tuffinmuffin/battery-cart/CAD/Fan/2510FanOverhead.png

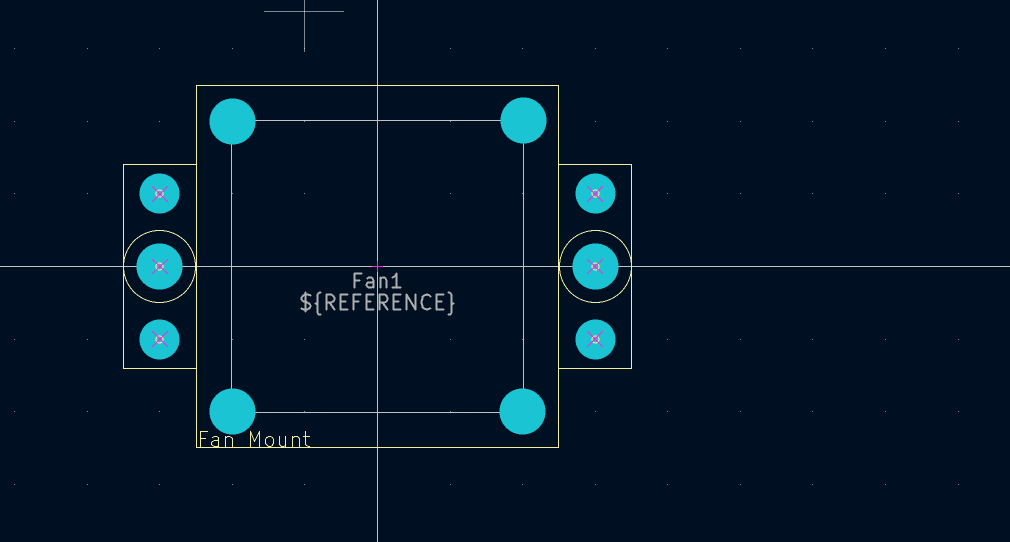
CAD/Fan/2510FanOverhead.png
