tuffinmuffin/battery-cart/Docs/frc_bom_v19.xlsx

Sheet: Bay PCB BOM
FRC Battery Monitor — Bay Control PCB BOM (Rev 0.1 · April 2026) Components soldered onto the bay board only.
Ref Des | Friendly Name | Qty | Description | Manufacturer | MPN | Package / Ordering note | Status | DigiKey / Order PN | MFR Datasheet | DK Datasheet | Price 1x | Price 10x | Stock | Notes / Design Requirements | KiCad Symbol | KiCad Footprint | Sch Page
Ordering policy: Packaging type (tube/cut tape/bulk) not relevant — priority is lowest per-unit cost at qty 1–10 for manual assembly. DigiKey cut tape / MouseReel / AliExpress singles all acceptable. Avoid full-reel minimums. Prices marked CHECK must be verified live — subject to tariffs.
1. MICROCONTROLLER
U1 | U1 | 1 | MCU — ARM Cortex-M0+ 64MHz USB FS I2C ADC 256KB flash | STMicroelectronics | STM32G0B1CCT6 | LQFP48 7×7mm 0.5mm pitch — singles or cut tape | SELECTED | STM32G0B1CCT6-ND (https://www.digikey.com/en/products/detail/stmicroelectronics/STM32G0B1CCT6/18086132) | MFR DS (https://www.st.com/resource/en/datasheet/stm32g0b1cc.pdf) | DK DS (https://www.digikey.com/en/products/detail/stmicroelectronics/STM32G0B1CCT6/18086132) | ~$2.80 | ~$2.50 | In Stock | 256KB flash · 144KB RAM · crystal-less USB FS · 64MHz · ~37 usable GPIO. LQFP48 7×7mm 0.5mm pitch — right-sized for this application. GPIO budget: 17 pins committed, ~20 spare. Same silicon as RCT6 (LQFP64) — identical firmware, peripherals, USB. Smaller footprint improves PCB placement. LQFP64 RCT6 rejected: 24 excess GPIO, larger footprint, ~$0.70 more. Dev board: NUCLEO-G0B1RE uses RCT6 — compatible for firmware dev, layout uses CCT6 pinout. | — | — | —
2. CURRENT / VOLTAGE MONITOR
U2 | U2 | 1 | Current/voltage/power monitor — I2C 16-bit bidirectional external shunt | Texas Instruments | INA226AQDGSRQ1 | VSSOP-10 0.5mm pitch — tube, singles | SELECTED | 296-43708-1-ND (https://www.digikey.com/en/products/detail/texas-instruments/INA226AQDGSRQ1/5404241) | MFR DS (https://www.ti.com/lit/ds/symlink/ina226.pdf) | DK DS (https://www.digikey.com/en/products/detail/texas-instruments/INA226AQDGSRQ1/5404241) | $2.58 | CHECK | 5.6M In Stock | 36V CM · ±81.92mV diff input · 16 I2C addr (0x40–0x4F) · 0.1% gain error · alert pin. Tube pkg (AIDGST) — easy singles. ⚑ VSSOP-10 0.5mm pitch: use flux + fine tip. Chosen over INA260: 57% cheaper, 5× better resolution, no obsolescence risk. | — | — | —
R1 | R_SHUNT | 1 | Current sense shunt — 10mΩ ±1% 2W metal strip 2512 | Vishay Dale | WSL2512R0100FEK18 | 2512 SMD — cut tape, singles | SELECTED | WSL-.01LFKR-ND (https://www.digikey.com/en/products/detail/vishay-dale/WSL2512R0100FEK18/9754181) | MFR DS (https://www.vishay.com/docs/20052/wsl.pdf) | DK DS (https://www.digikey.com/en/products/detail/vishay-dale/WSL2512R0100FEK18/9754181) | ~$0.50 | ~$0.40 | In Stock | 10mΩ: 5A→50mV ✓ 1.8A→18mV ✓ 250mW at 5A (well within 2W). TCR ±75ppm/°C. 2512 large pads — hand-solderable. ⚑ LAYOUT: Kelvin routing — sense traces to INA226 IN+/IN− at inner pad edges only. | MCU_ST_STM32G0:STM32G0B1CCTx | Package_QFP:LQFP-48_7x7mm_P0.5mm | 3-MCU
⚑ INA226 required passives and connections: (1) C_INA_VS: 100nF ceramic directly at VS pin — mandatory per TI datasheet typical application. (2) R_ALERT: 10kΩ pull-up from ALERT pin to VS (3.3V) — enables interrupt-driven fault detection. (3) A0/A1: both tie directly to GND via short trace → I2C address 0x40. No resistors needed. (4) VBUS pin: connect to IN− node (battery terminal, load side of shunt) to read terminal voltage. ALERT active-low open-drain: pulls low on over-current/over-voltage/under-voltage/conversion-ready. STM32 GPIO configured as input with internal pull-up (40kΩ typ), falling-edge interrupt. No external R_ALERT needed — STM32 internal pull-up adequate (82µA sink at 40kΩ, well within INA226 10mA IOUT max). VBUS: 100nF DNP footprint (C_VBUS) for optional ripple suppression when no battery present.
C17 | C_INA_VS | 1 | 100nF X7R 10V 0603 — INA226 VS power supply bypass | Generic | 100nF X7R 10V 0603 | 0603 — cut tape | SELECTED | — | — | — | ~$0.01 | ~$0.01 | In Stock | Mandatory per INA226 datasheet typical application circuit. Place immediately adjacent to VS pin (pin 6). Low-ESR X7R ceramic. This is a precision analog IC — bypass cap placement is critical for measurement accuracy. LAYOUT: within 2mm of VS pin, GND via immediately adjacent. | — | — | —
C19 | C19 | 1 | 100nF X7R 25V 0603 — INA226 VBUS ripple filter — DNP default | Generic | 100nF X7R 25V 0603 | 0603 — cut tape | DNP | — | — | — | ~$0.01 | ~$0.01 | In Stock | DNP in normal operation — battery bulk capacitance suppresses charger ripple adequately. Populate if VBUS ripple causes measurement noise during bring-up (charger connected, no battery). Charger is designed to run unloaded and does not spike — 25V rating is precautionary headroom only. Relay NC fail-safe connects CHG+ to battery path when MCU off — board transparent to charger. 100nF same value as C_BYPASS — no new stock needed. | — | — | —
3. POWER SUPPLY
U3 | U3 | 1 | Buck converter — 12V → 3.3V 2A, primary rail (12V present) | Diodes Inc | AP63203WU-7 | SOT-23-6 (TSOT-26) — singles or cut tape | SELECTED | AP63203WU-7DICT-ND (https://www.digikey.com/en/products/detail/diodes-incorporated/AP63203WU-7/9858430) | MFR DS (https://www.diodes.com/assets/Datasheets/AP63200-AP63201-AP63203-AP63205.pdf) | DK DS (https://www.digikey.com/en/products/detail/diodes-incorporated/AP63203WU-7/9858430) | ~$0.60 | ~$0.50 | In Stock | 3.8–32V input · fixed 3.3V output · 2A · integrated MOSFETs · FSS EMI reduction · PG open-drain pin. Requires 4 external passives: L1 (3.9µH), C_IN (10µF), C_OUT (22µF), C_BST (100nF). PG open-drain pin connects directly to MIC5219 EN via R_PG pull-up — no transistor needed. | — | — | —
U4 | U4 | 1 | LDO regulator — VBUS 5V → 3.3V, USB-only fallback (12V absent) | Microchip | MIC5219-3.3YM5-TR | SOT-23-5 — singles or cut tape | SELECTED | MIC5219-3.3YM5-TRCT-ND (https://www.digikey.com/en/products/detail/microchip-technology/MIC5219-3.3YM5-TR/771902) | MFR DS (https://ww1.microchip.com/downloads/en/DeviceDoc/MIC5219.pdf) | DK DS (https://www.digikey.com/en/products/detail/microchip-technology/MIC5219-3.3YM5-TR/771902) | ~$0.50 | ~$0.40 | In Stock | 500mA · low noise · EN pin (active-high) · NO active output discharge — output decays passively through load. EN driven directly by AP63203 PG pin via R_PG pull-up to VBUS. No transistor needed. PG asserted (low, 12V healthy) → EN low → LDO off. PG released (12V absent) → EN pulled high via R_PG → LDO on from VBUS. MIC5219 chosen over AP2112K specifically because AP2112K has active auto-discharge which would fight the buck rail during startup. MIC5219 shuts down passively — safe to share rail. USB always connected to Pi for CDC data — VBUS always present. Board draw at 3.3V ≈ 170–200mA — within 500mA rating. | Regulator_Switching:AP63203WU-7 | Package_TO_SOT_SMD:SOT-23-6 | 2-PwrSupply
⚑ Power OR-ing/mux IC (originally designated U5) ELIMINATED — no discrete power mux IC needed for 3.3V rail. A dedicated power multiplexer IC was initially considered to OR the buck and LDO outputs onto the 3.3V rail, but was eliminated when it was found that AP63203 PG pin drives MIC5219 EN directly via R_PG pull-up — the PG/EN logic relationship maps correctly without any additional IC or transistor inversion. Q_PG transistor also eliminated for same reason. R_EN eliminated — R_PG pull-up to VBUS serves both roles. NOTE: U5 designator subsequently re-assigned to AP63205 5V_LED buck converter (Section 3b).
R9 | R_PG | 1 | 100kΩ ±5% 0603 — pull-up: AP63203 PG to VBUS, also drives MIC5219 EN | Generic | 100kΩ ±5% 0603 | 0603 — cut tape, singles | SELECTED | — | — | — | ~$0.01 | ~$0.01 | In Stock | PG is open-drain active-low. Pull-up to VBUS ensures EN is high (LDO on) when 12V absent. When PG asserts low, it pulls EN low through this resistor — no transistor inversion needed because MIC5219 EN is active-high and PG active-low maps correctly: PG low = EN low = LDO off. | Device:R | Resistor_SMD:R_0603_1608Metric | 2-PwrSupply
L1 | L1 | 1 | Inductor — 3.9µH shielded power inductor for AP63203 buck converter | Bourns | SRR4028-3R9Y | 4.8×4.8×2.8mm SMD — singles or cut tape | SELECTED | SRR4028-3R9YCTR-ND (https://www.digikey.com/en/products/detail/bourns-inc/SRR4028-3R9Y/2127507) | MFR DS (https://www.bourns.com/docs/Product-Datasheets/SRR4028.pdf) | DK DS (https://www.digikey.com/en/products/detail/bourns-inc/SRR4028-3R9Y/2127507) | ~$0.35 | ~$0.28 | In Stock | 3.9µH per AP63203 Table 2/3 recommendation (not 4.7µH — that is the AP63205 5V variant). Shielded drum core · Irms 1.72A · DCR 60mΩ max · 4.8×4.8×2.8mm. At our ~200mA actual load, peak ripple current ≈0.48A — well within 1.72A rating. DCR 60mΩ < 100mΩ datasheet limit. | Device:L | Inductor_SMD:L_Bourns_SRR4028 | 2-PwrSupply
C4 | C_12V_IN | 1 | 10µF ±20% X5R 25V 0805 — 12V rail bulk cap at board entry | Generic | 10µF X5R 25V 0805 | 0805 — cut tape, singles | SELECTED | — | — | — | ~$0.05 | ~$0.04 | In Stock | Bulk capacitor on 12V rail at entry point — after F1 fuse, before branching to U3/U5/relay. Absorbs connector insertion inductance and any ESD transients from battery connection. Same value as C_IN/C_5V_IN — one value to stock. 25V rating = 2× 12V input. LAYOUT: place close to input connector, on the load side of F1. | — | — | —
C5 | C_U4_IN | 1 | 1µF ±20% X5R 10V 0603 — MIC5219 LDO VIN bypass | Generic | 1µF X5R 10V 0603 | 0603 — cut tape, singles | SELECTED | — | — | — | ~$0.02 | ~$0.01 | In Stock | MIC5219 datasheet: 1µF input cap recommended. VIN = VBUS (5V). LAYOUT: place close to U4 VIN pin. | — | — | —
C6 | C_U4_OUT | 1 | 1µF ±20% X5R 10V 0603 — MIC5219 LDO VOUT cap (stability required) | Generic | 1µF X5R 10V 0603 | 0603 — cut tape, singles | SELECTED | — | — | — | ~$0.02 | ~$0.01 | In Stock | MIC5219 datasheet: minimum 1µF output cap required for stability — do not omit. Without output cap LDO may oscillate. Low-ESR ceramic only. LAYOUT: place immediately adjacent to U4 VOUT pin, before connecting to 3.3V rail. 3.3V rail bulk (C_BULK_3V3, C_VDD_BULK) are additional — this is the LDO-local stability cap. | — | — | —
C1 | C_IN | 1 | 10µF ±20% X5R 25V 0805 — AP63203 input cap, ripple suppression | Generic | 10µF X5R 25V 0805 | 0805 — cut tape, singles | SELECTED | — | — | — | ~$0.05 | ~$0.04 | In Stock | Per AP63203 datasheet Table 2. Low ESR ceramic. 25V rating = 2×Vin headroom on 12V supply. Place close to VIN and GND pins. | — | — | —
C2 | C_OUT | 1 | 22µF ±20% X5R 6.3V 0805 — AP63203 output cap, ripple and transient | Generic | 22µF X5R 6.3V 0805 | 0805 — cut tape, singles | SELECTED | — | — | — | ~$0.08 | ~$0.06 | In Stock | Per AP63203 datasheet Table 2. Low ESR ceramic. 6.3V rating ≥ 2×Vout (3.3V). Single 22µF sufficient at our load — add second in parallel if ripple measurement requires. | — | — | —
C3 | C_BST | 1 | 100nF X7R 10V 0402 — AP63203 bootstrap cap, BST to SW pin | Generic | 100nF X7R 10V 0402 | 0402 — cut tape, singles | SELECTED | — | — | — | ~$0.01 | ~$0.01 | In Stock | Required by AP63203 — must be placed between BST and SW pins. If BST cap voltage drops below 2.3V, internal UVP circuit refreshes it. 100nF ceramic. | — | — | —
3b. 5V LED POWER RAIL — DEDICATED SUPPLY FOR LED CHAIN
⚑ Dedicated 5V rail powering the WS2812B LED chain and level shifter. Sources from 12V via AP63205 buck, OR from VBUS (USB 5V) via Schottky diode — whichever is present. Architecture: 12V → U5(AP63205) → D_12V(Schottky) ─┬─ 5V_LED rail → LEDs + level shifter. VBUS → D_USB(Schottky) ─┘ This ensures LEDs operate (showing bay status) whenever 12V OR USB is present — including when Pi is off. WS2812B spec: VDD 3.5–5.3V, nominal 5V. Running at proper 5V eliminates out-of-spec concerns. Worst case draw: 6 LEDs × 54mA (full white) = 324mA. Typical: ~65mA at 20% brightness. U5 rated 2A — 6× worst-case headroom. Same part family as U3 (AP63203): identical footprint, same passives.
U5 | U5 | 1 | Buck converter — 12V → 5V 2A, LED chain power rail | Diodes Inc | AP63205WU-7 | SOT-23-6 (TSOT-26) — singles or cut tape | SELECTED | AP63205WU-7DICT-ND (https://www.digikey.com/en/products/detail/diodes-incorporated/AP63205WU-7/9858424) | MFR DS (https://www.diodes.com/assets/Datasheets/AP63200-AP63201-AP63203-AP63205.pdf) | DK DS (https://www.digikey.com/en/products/detail/diodes-incorporated/AP63205WU-7/9858424) | ~$0.70 | ~$0.60 | In Stock | 3.8–32V input · fixed 5V output · 2A · same die/package as U3(AP63205) · FSS EMI reduction. Identical footprint to U3 — share PCB footprint library entry. Efficiency ~85% at 12V→5V, 100mA typical load vs LDO worst-case 7V×324mA=2.3W dissipation. Passives same family as U3: L2(4.7µH), C_5V_IN(10µF), C_5V_OUT(22µF), C_BST2(100nF). Surge rated to 40V for 400ms — handles 12V battery transients. | — | — | —
L2 | L2 | 1 | Inductor — 4.7µH shielded power inductor for AP63205 5V buck | Bourns | SRR4028-4R7Y | 4.8×4.8×2.8mm SMD — singles | SELECTED | SRR4028-4R7YCTR-ND (https://www.digikey.com/en/products/detail/bourns-inc/SRR4028-4R7Y/2127508) | MFR DS (https://www.bourns.com/docs/Product-Datasheets/SRR4028.pdf) | DK DS (https://www.digikey.com/en/products/detail/bourns-inc/SRR4028-4R7Y/2127508) | ~$0.35 | ~$0.28 | In Stock | 4.7µH per AP63205 Table 3 recommendation for 5V output. Same SRR4028 series as L1 — identical footprint, different value. Irms 1.52A · DCR 75mΩ max. Well within rating at 324mA worst case. | Regulator_Switching:AP63205WU-7 | Package_TO_SOT_SMD:SOT-23-6 | 2-PwrSupply
D2 | D_12V | 1 | Schottky diode — 12V→5V reg output to 5V_LED rail (backfeed isolation) | MCC | MBR0530-TP | SOD-123 — singles | SELECTED | MBR0530TPMSCT-ND (https://www.digikey.com/en/products/detail/mcc-micro-commercial-components/MBR0530-TP/717251) | — | — | ~$0.14 | ~$0.11 | In Stock | 30V 500mA Schottky. Isolates 12V buck output from VBUS path. Vf ~0.35V @ 500mA — 5V_LED rail will be ~4.65V at full load. Acceptable for WS2812B (min 3.5V). | — | — | —
D3 | D_USB | 1 | Schottky diode — VBUS to 5V_LED rail (backfeed isolation from USB) | MCC | MBR0530-TP | SOD-123 — singles | SELECTED | MBR0530TPMSCT-ND (https://www.digikey.com/en/products/detail/mcc-micro-commercial-components/MBR0530-TP/717251) | — | — | ~$0.14 | ~$0.11 | In Stock | Same part as D_12V. Prevents 5V_LED rail backfeeding into VBUS when USB is absent. When both sources present: higher voltage wins (buck output will dominate slightly). | — | — | —
C7 | C_5V_IN | 1 | 10µF ±20% X5R 25V 0805 — AP63205 input cap | Generic | 10µF X5R 25V 0805 | 0805 — cut tape | SELECTED | — | — | — | ~$0.05 | ~$0.04 | In Stock | Same value as C_IN. Place close to U5 VIN pin. | — | — | —
C8 | C_5V_OUT | 1 | 22µF ±20% X5R 10V 0805 — AP63205 output cap | Generic | 22µF X5R 10V 0805 | 0805 — cut tape | SELECTED | — | — | — | ~$0.08 | ~$0.06 | In Stock | 10V rating ≥ 2×Vout(5V). Same as C_OUT. Place close to U5 output. | — | — | —
C9 | C_BST2 | 1 | 100nF X7R 10V 0402 — AP63205 bootstrap cap | Generic | 100nF X7R 10V 0402 | 0402 — cut tape | SELECTED | — | — | — | ~$0.01 | ~$0.01 | In Stock | Same as C_BST. Required between U5 BST and SW pins. Place immediately adjacent. | — | — | —
4. SWITCHING — RELAY & DRIVERS
K1 | K1 | 1 | SPDT relay — CHG+ switching, NC=charger (fail-safe), NO=bleed load path | Omron | G5LE-1 DC3 | PCB mount TH 5-pin — singles | SELECTED | Z3329-ND (https://www.digikey.com/en/products/detail/omron-electronics-inc-emc-div/G5LE-1-DC3/1815676) | MFR DS (https://omronfs.omron.com/en_US/ecb/products/pdf/en-g5le.pdf) | DK DS (https://www.digikey.com/en/products/detail/omron-electronics-inc-emc-div/G5LE-1-DC3/1815676) | $1.77 | CHECK | In Stock | SPDT 1 Form C · 3V rated coil · 10A AC / 8A DC contacts · 30VDC max · 22.5×16.5×19mm · 400mW coil. Must-operate = 75% of 3V = 2.25V — 3.3V rail via Q2 NPN is well above threshold. Coil draws 133mA — Q2 handles this, not GPIO direct. NC = CHG+ connected at rest (fail-safe). NO = bleed resistor top (test state). ⚑ No 5V rail on board — 3.3V rail only. Ref schematic: battery_test_protection_charging_circuit.svg | — | — | —
Q5 | Q4 (Fan FET) | 1 | NPN transistor — K1 relay coil driver (3.3V GPIO → 3V coil) | Generic | MMBT2222A or BC817-25LT1G | SOT-23 — cut tape, singles | SELECTED | — | — | — | ~$0.05 | ~$0.04 | In Stock | STM32 GPIO → R_GATE_K1 1kΩ → Q2 base. Collector drives 3V coil from 3.3V rail. Coil current 133mA — within transistor spec, well above 25mA GPIO limit. D1 flyback across coil. Candidates: MMBT2222A (SOT-23, ~$0.05 DK). | Device:Relay_SPDT | Relay_THT:Relay_SPDT_Omron-G5LE-1 | 1-BattPwr
D1 | D1 | 1 | Flyback diode — K1 relay coil transient suppression | Diodes Inc | 1N4148W-7-F | SOD-123 — cut tape, singles | SELECTED | 1N4148W-FDICT-ND (https://www.digikey.com/en/products/detail/diodes-incorporated/1N4148W-7-F/717311) | MFR DS (https://www.diodes.com/assets/Datasheets/ds30086.pdf) | DK DS (https://www.digikey.com/en/products/detail/diodes-incorporated/1N4148W-7-F/717311) | ~$0.03 | ~$0.02 | In Stock | Across K1 relay coil — cathode to 3.3V rail, anode to Q2 collector. Clamps coil back-EMF on relay release. SOD-123 hand-solderable. | — | — | —
5. FUSES — 12V INPUT PROTECTION (MINI BLADE / ATM)
⚑ All three 12V inputs fused with automotive mini blade (ATM/297 series). Holders PCB-mount through-hole — MPD BK-6013 (vertical entry mini blade). Fuses user-replaceable, color-coded, available at any auto parts store. Same ATM format as REV PDH low-current channels — teams will have spares in kit. Sizing provisional: F1+F2 = 7.5A, F3 = 2A. All easily swappable. Rated 32V DC.
F1 | F1 | 1 | Mini blade fuse 7.5A — BAT+ input protection (provisional) | Littelfuse | 02970007.5WXNV | Mini blade ATM — singles | SELECTED | WK-02970007.5WXNV-ND (https://www.digikey.com/en/products/detail/littelfuse-inc/02970007-5wxnv/762533) | MFR DS (https://www.littelfuse.com/~/media/automotive/datasheets/fuses/passenger-car/blade/littelfuse_atm.pdf) | DK DS (https://www.digikey.com/en/products/detail/littelfuse-inc/02970007-5wxnv/762533) | ~$0.25 | ~$0.20 | In Stock | 7.5A 32V mini blade (ATM). BAT+ path. Provisional — sizing TBD after load testing. Same format as REV PDH low-current fuses. Brown. Easily replaceable. | — | — | —
F2 | F2 | 1 | Mini blade fuse 7.5A — CHG+ input protection | Littelfuse | 02970007.5WXNV | Mini blade ATM — singles | SELECTED | WK-02970007.5WXNV-ND (https://www.digikey.com/en/products/detail/littelfuse-inc/02970007-5wxnv/762533) | MFR DS (https://www.littelfuse.com/~/media/automotive/datasheets/fuses/passenger-car/blade/littelfuse_atm.pdf) | DK DS (https://www.digikey.com/en/products/detail/littelfuse-inc/02970007-5wxnv/762533) | ~$0.25 | ~$0.20 | In Stock | 7.5A 32V mini blade (ATM). CHG+ path. Provisional — same value as F1 for simplicity. Same format as REV PDH low-current fuses. Brown. Easily replaceable. | Device:D_Schottky | Diode_SMD:D_SOD-123 | 1-BattPwr
F3 | F3 | 1 | Mini blade fuse 2A — 12V rail input to buck converter | Littelfuse | 0297002.WXNV | Mini blade ATM — singles | SELECTED | WK-0297002.WXNV-ND (https://www.digikey.com/en/products/detail/littelfuse-inc/0297002-wxnv/762528) | MFR DS (https://www.littelfuse.com/~/media/automotive/datasheets/fuses/passenger-car/blade/littelfuse_atm.pdf) | DK DS (https://www.digikey.com/en/products/detail/littelfuse-inc/0297002-wxnv/762528) | ~$0.25 | ~$0.20 | In Stock | 2A 32V mini blade (ATM). 12V rail to AP63203 buck. Provisional. Buck draws ~200mA at 12V — 2A gives 10× normal current margin. Grey. | — | — | —
FH1 FH2 FH3 | FH1 FH2 FH3 | 3 | Fuse holder — mini blade ATM vertical PCB through-hole (one per fuse) | MPD | BK-6013 | PCB TH vertical — singles | SELECTED | BK-6013-ND (https://www.digikey.com/product-detail/en/BK-6013/BK-6013-ND/2330532) | MFR DS (https://www.memoryprotectiondevices.com/documents/catalogs/MPD-Fuse-Holders.pdf) | DK DS (https://www.digikey.com/product-detail/en/BK-6013/BK-6013-ND/2330532) | ~$0.65 | ~$0.50 | In Stock | MPD BK-6013 — compact vertical holder with body for .110"×.032" mini blade (ATM). Glass-filled nylon body · nickel-plated brass contacts · PC pins · RoHS. Compatible with Littelfuse 297/ATM series. ~$0.65 DK single unit vs ~$1.20 for Keystone 3568. Keystone 3544-2 equivalent. One footprint for all three positions. | — | — | —
6. PROTECTION — POLARITY GUARD & LOAD SWITCH
Q1 | Q1 (Polarity Guard) | 1 | P-channel MOSFET — BAT+ reverse polarity guard (series, normally on) | Alpha & Omega | AO3401A | SOT-23-3 — cut tape, singles | SELECTED | AO3401A-ND (https://www.digikey.com/en/products/detail/alpha-omega-semiconductor-inc/AO3401A/1855773) | MFR DS (https://www.aosmd.com/res/datasheets/AO3401A.pdf) | DK DS (https://www.digikey.com/en/products/detail/alpha-omega-semiconductor-inc/AO3401A/1855773) | ~$0.46 | ~$0.37 | In Stock | Vds = −30V · Id = −4.0A steady-state (−18A pulsed) · Vgs(th) max −1V · RDS(on) < 50mΩ @ −10V. Adequate for reverse polarity guard: in normal op Q1 conducts ≤6.8A for short bleed-test duty cycles. F1 (7.5A) blows before Q1 thermals in true reverse/fault. DMG2305UX rejected: Vds = −20V too tight vs 14.4V FRC battery max. | — | — | —
R2 | R_G1 | 1 | 10kΩ ±5% 0603 — Q1 P-FET gate pull-down to GND | Generic | 10kΩ 0603 | 0603 preferred | SELECTED | — | — | — | ~$0.01 | ~$0.01 | In Stock | Q1 gate tied to GND via R_G1. Source = BAT+, so Vgs = 0 − BAT+ = negative → FET conducts normally. R_G1 defines gate firmly at GND — prevents floating gate during power-up and provides ESD discharge path. No switching required — Q1 is always-on series guard. No gate drive or turn-on resistor needed. 10kΩ same value as R_BOOT0 — one value to stock. | Device:Q_PMOS_GSD | Package_TO_SOT_SMD:SOT-23 | 1-BattPwr
5b. Q3 BLEED MOSFET — DUAL FOOTPRINT (TO-220 TH primary · D2PAK SMD alt)
⚑ DUAL FOOTPRINT: PCB carries both TO-220 through-hole pads and D2PAK (TO-263) SMD pads for Q3. Same electrical position — populate ONE only. TO-220 (IRFZ44NPBF) is primary; D2PAK (IRFZ44NSPBF) is SMD alternative, same die. Both require Q3_DRV NPN driver circuit. Silkscreen both outlines. Shared drain/source nodes. Courtyard = larger of the two.
Q5 | Q4 (Fan FET) | 1 | N-channel MOSFET — bleed load enable, low-side switch — TO-220 PRIMARY | Infineon | IRFZ44NPBF | TO-220AB through-hole | SELECTED | IRFZ44NPBF-ND (https://www.digikey.com/en/products/detail/infineon-technologies/IRFZ44NPBF/811772) | MFR DS (https://www.infineon.com/dgdl/Infineon-IRFZ44N-DataSheet-v01_01-EN.pdf) | DK DS (https://www.digikey.com/en/products/detail/infineon-technologies/IRFZ44NPBF/811772) | ~$1.39 | ~$1.11 | In Stock | Vds = 55V · Id = 49A · RDS(on) max 17.5mΩ @ Vgs=10V (fully guaranteed at spec drive voltage) · Standard threshold — driven at 10–12V via Q3_DRV NPN stage (see below). No heatsink needed: at 1.82A nominal P = 0.058W, TJ rise < 4°C in free air. DUAL FOOTPRINT: also fits IRFZ44NSPBF D2PAK on same pads. | — | — | —
Q5 | Q4 (Fan FET) | 1 | N-channel MOSFET — bleed load enable, low-side switch — D2PAK SMD ALTERNATIVE | Infineon | IRFZ44NSPBF | D2PAK (TO-263) SMD — same die as IRFZ44NPBF | DUAL | IRFZ44NSPBF-ND (https://www.digikey.com/en/products/detail/infineon-technologies/IRFZ44NSPBF/811988) | MFR DS (https://www.infineon.com/dgdl/Infineon-IRFZ44N-DataSheet-v01_01-EN.pdf) | DK DS (https://www.digikey.com/en/products/detail/infineon-technologies/IRFZ44NSPBF/811988) | ~$1.55 | ~$1.24 | In Stock | Identical silicon to IRFZ44NPBF. D2PAK tab-down SMD, copper pour on drain tab. Populate instead of TO-220 if SMD-only assembly preferred. Same driver circuit required. | Device:Q_NMOS_GDS | Package_TO_SOT_THT:TO-220-3_Vertical | 1-BattPwr
5c. Q3_DRV — NPN DRIVER FOR Q3 GATE
⚑ Q3 driven via NPN stage: STM32 GPIO (3.3V) → R_B3 → Q3_DRV base → collector pulls Q3 gate to GND (off). 12V rail via R_G3 (100Ω) charges Q3 gate to ~12V when Q3_DRV off (on). Logic inverted: GPIO HIGH = Q3 OFF, GPIO LOW = Q3 ON. Handle with invert flag in firmware. Same topology as Q2 relay driver. MMBT2222A already in BOM — same part, new instance.
Q5 | Q4 (Fan FET) | 1 | NPN transistor — Q3 gate driver (inverts STM32 GPIO to 12V gate drive) | Onsemi | MMBT2222ALT1G | SOT-23 SMD — same part as Q2 | SELECTED | MMBT2222ALT1GOSCT-ND (https://www.digikey.com/en/products/detail/onsemi/MMBT2222ALT1G/919595) | MFR DS (https://www.onsemi.com/pdf/datasheet/mmbt2222a-d.pdf) | DK DS (https://www.digikey.com/en/products/detail/onsemi/MMBT2222ALT1G/919595) | ~$0.05 | ~$0.04 | In Stock | Same part as Q2 NPN relay driver — one part number for both. Base current from 3.3V GPIO through R_B3 (4.7kΩ) ≈ 0.5mA — well within GPIO drive. Collector to Q3 gate + R_G3 node. Saturation guaranteed at this base current. | — | — | —
R5 | R_B3 | 1 | 4.7kΩ ±5% — Q3_DRV NPN base resistor | Generic | 4.7kΩ 0603 | 0603 preferred | GENERIC | — | — | — | ~$0.01 | ~$0.01 | In Stock | Sets base current: (3.3V - 0.7V) / 4.7kΩ ≈ 0.55mA. Vce(sat) < 0.3V at this drive. 0603 or larger. | — | — | —
R3 | R_G3 | 1 | 100Ω ±5% — Q3 gate pull-up to 12V rail | Generic | 100Ω 0603 | 0603 preferred | GENERIC | — | — | — | ~$0.01 | ~$0.01 | In Stock | Limits gate current inrush. When Q3_DRV off: 12V charges Q3 gate through R_G3. When Q3_DRV on: collector sinks gate current through R_G3 to GND. 0603 or larger. | — | — | —
R4 | R_BOOT_G3 (Q3 Base Pull-down) | 1 | 100kΩ ±5% 0603 — Q3 (NPN driver) base pull-down to GND (defined off at power-up) | Generic | 100kΩ 0603 | 0603 preferred | SELECTED | — | — | — | ~$0.01 | ~$0.01 | In Stock | Pull-down on Q3 (MMBT2222A) base, not Q2 gate. Keeps Q3 base firmly at GND during MCU boot before GPIO is configured — Q3 off → Q2 (IRFZ44N) gate not driven → bleed FET stays off. Correct location: preventing Q3 turn-on is the right intervention point. Q2 gate naturally held low through Q3 collector when Q3 is off. 100kΩ same value as R_CHG_H/R_12V_H/R_BAT_H — one value to stock. | — | — | —
6. BLEED LOAD RESISTORS — DUAL FOOTPRINT
⚑ DUAL FOOTPRINT: inner pads = SQP500 (~30mm lead span), outer pads = SQP10A (~55mm). Shared inner pad. Drill 1.0mm. Horizontal mount on 5mm standoffs. Silkscreen both body outlines. Courtyard = SQP10A (48mm) envelope. Populate one option only.
R7 R8 | R_BLEED1 R_BLEED2 | 2 | 3.3Ω ±5% 5W cement wirewound axial — Option A PRIMARY | Yageo | SQP500JB-3R3 | Axial TH bulk — singles, no minimum | SELECTED | 3.3W-5-ND (https://www.digikey.com/en/products/detail/yageo/SQP500JB-3R3/18643) | MFR DS (https://yageogroup.com/content/datasheet/asset/file/YAGEO-SQP_NSP_DATASHEET) | DK DS (https://www.digikey.com/en/products/detail/yageo/SQP500JB-3R3/18643) | ~$0.20 | ~$0.16 | In Stock | 5W · 22×9.5mm · ~30mm lead span · flameproof cement. Series pair = 6.6Ω ~1.8A at 12V. NTC between bodies. | — | — | —
R7 R8 | R_BLEED1 R_BLEED2 | 2 | 3.3Ω ±5% 10W cement wirewound axial — Option B HIGHER MARGIN | Yageo | SQP10AJB-3R3 | Axial TH bulk — singles, no minimum | DUAL | 3.3W10-ND (https://www.digikey.com/en/products/detail/yageo/SQP10AJB-3R3/18723) | MFR DS (https://yageogroup.com/content/datasheet/asset/file/YAGEO-SQP_NSP_DATASHEET) | DK DS (https://www.digikey.com/en/products/detail/yageo/SQP10AJB-3R3/18723) | ~$0.45 | ~$0.36 | In Stock | 10W · 48×9.5mm · ~55mm lead span. Fits same shared inner pad footprint. | — | — | —
7. THERMAL — NTC THERMISTOR
RT1 | RT1 | 1 | NTC thermistor 10kΩ 3380K — bleed resistor thermal monitor | TDK | NTCG103JF103FT1 | 0402 SMD — cut tape, singles | SELECTED | 445-2082-1-ND (https://www.digikey.com/en/products/detail/tdk-corporation/NTCG103JF103FT1/571299) | MFR DS (https://product.tdk.com/en/search/sensor/ntc/chip_ntc_thermistor/info?part_no=NTCG103JF103FT1) | DK DS (https://www.digikey.com/en/products/detail/tdk-corporation/NTCG103JF103FT1/571299) | ~$0.10 | ~$0.08 | In Stock | 10kΩ @ 25°C · B25/85 = 3380K · 0402 · 559K DK stock. Place between R_BLEED1 and R_BLEED2 — sense only, not in series. Feeds STM32 ADC via 10kΩ divider. Over-temp → STM32 disables Q3. Same B-constant as 0603 sibling NTCG163JF103FT1 — firmware constants identical. 0402 chosen to fit between bleed resistor bodies. | Device:R_Thermistor_NTC | Resistor_SMD:R_0402_1005Metric | 3-MCU
7b. FAN CONTROL — PWM N-FET + VOLTAGE SELECT
⚑ Small fan driven via N-channel MOSFET (Q4) on PA6/TIM3_CH1 PWM. Voltage selectable via 3-pin jumper header (J_FAN_SEL): pins 1-2 = 12V, pins 2-3 = 5V_LED. Fan connector (J_FAN) is standard PC 2-pin 2.54mm KK-style. Gate held low at boot via R_FAN_PD (100kΩ to GND) — fan off until firmware starts. R_FAN_G (100Ω series) damps gate ringing. Flyback diode D_FAN across fan terminals — brushed DC fans are inductive loads. Firmware: TIM3_CH1 on PA6 → PWM at ~25kHz → Q4 gate → fan speed proportional to NTC temp. Fan off below threshold, ramps linearly, full speed above over-temp limit.
Q5 | Q4 (Fan FET) | 1 | N-ch MOSFET SOT-23 — fan PWM switch (IRLML2502TRPBF) | Infineon | IRLML2502TRPBF | SOT-23 — cut tape | SELECTED | IRLML2502TRPBFCT-ND (https://www.digikey.com/en/products/detail/infineon-technologies/IRLML2502TRPBF/811439) | MFR DS (https://www.infineon.com/dgdl/irlml2502pbf.pdf?fileId=5546d462533600a4015356719c2c1b4b) | DK DS (https://www.digikey.com/en/products/detail/infineon-technologies/IRLML2502TRPBF/811439) | ~$0.45 | ~$0.36 | In Stock | N-ch, 20V, 4.2A, SOT-23. Vgs(th) max 1.0V — fully enhanced at 3.3V gate. Rds(on)=45mΩ at Vgs=4.5V. Gate driven directly from PA6/TIM3_CH1 via R_FAN_G (100Ω). More than adequate for any 5V or 12V fan ≤1A. Same SOT-23 footprint as Q1/Q2. | Device:Q_NMOS_GDS | Package_TO_SOT_SMD:SOT-23 | 4-IO
D4 | D_FAN | 1 | Schottky diode SOD-123 — fan flyback (1N4148W-7-F) | Diodes Inc. | 1N4148W-7-F | SOD-123 — cut tape | SELECTED | 1N4148W-FDICT-ND (https://www.digikey.com/en/products/detail/diodes-incorporated/1N4148W-7-F/814371) | MFR DS (https://www.diodes.com/assets/Datasheets/ds30086.pdf) | DK DS (https://www.digikey.com/en/products/detail/diodes-incorporated/1N4148W-7-F/814371) | ~$0.03 | ~$0.02 | In Stock | Same part as D1 (relay flyback) — one part number for both. Place across J_FAN pins, cathode to V+ side. Clamps inductive kick from fan motor on PWM switching. | Device:D_Schottky | Diode_SMD:D_SOD-123 | 4-IO
R22 | R_FAN_G | 1 | 100Ω ±5% 0603 — Q4 gate series resistor | Generic | 0603 | 0603 — cut tape | SELECTED | — | — | — | ~$0.01 | ~$0.01 | In Stock | Damps gate ringing on PWM switching. Same value as R_G3 — one resistor value covers both. | — | — | —
R23 | R_FAN_PD | 1 | 100kΩ ±5% 0603 — Q4 gate pull-down | Generic | 0603 | 0603 — cut tape | SELECTED | — | — | — | ~$0.01 | ~$0.01 | In Stock | Holds Q4 gate low at power-up before firmware starts — fan off during boot. Same value as R_BOOT_G3 — same resistor bin. | — | — | —
J5 | J_FAN | 1 | 2-pin 2.54mm KK header — PC fan connector | Generic | 2-pin 2.54mm TH | 2-pin KK-style — singles | GENERIC | — | — | — | ~$0.08 | ~$0.06 | In Stock | Standard PC fan 2-pin 2.54mm header. Pin 1=GND · Pin 2=Fan V+ (from J_FAN_SEL). Mates with standard PC fan 2-pin JST/KK connector present on most small 5V/12V fans. Molex 22-28-4023 or equiv. Footprint at board edge. | Connector:Conn_01x02_Male | Connector_PinHeader_2.54mm:PinHeader_1x02_P2.54mm_Vertical | 4-IO
J6 | J_FAN_SEL | 1 | 3-pin 2.54mm header — fan voltage select (12V / FAN+ / 5V) | Generic | 3-pin 2.54mm TH | 3-pin — singles | GENERIC | — | — | — | ~$0.08 | ~$0.06 | In Stock | Voltage selector jumper header. Pin 1=12V · Pin 2=Fan V+ (to J_FAN/Q4 drain) · Pin 3=5V_LED. Jumper pins 1-2: fan runs on 12V. Jumper pins 2-3: fan runs on 5V_LED. Standard 2.54mm jumper shunt (from parts bin). No specific part needed. | — | — | —
8. STATUS LEDs — WS2812B ADDRESSABLE CHAIN
⚑ Full chain: STM32 GPIO → R24 (470Ω) → LED1 (SMD, PCB) → LED2 (SMD, PCB) → J_LED connector → LED1/2/3(5mm TH, front panel). 5 LEDs total on 1 GPIO. Powered from 5V_LED rail — WS2812B runs at proper spec voltage, no compromise. LED1/LED2: onboard SMD for bring-up visibility without front panel connected. LED1/2/3: 5mm TH, leads bent 90° for right-angle board-edge mounting toward front panel. J_LED connector (TBD type) carries 5V/GND/DATA to front panel — add more LEDs in firmware only, zero hardware changes. WS2812B protocol: 800kHz NZR. STM32 drives via DMA+timer. No current-limit resistors — IC built into each LED.
LED1 LED2 | LED_DBG1 LED_DBG2 | 2 | Addressable RGB LED SMD 5050 WS2812B — onboard debug, DigiKey | Xinglight | XL-5050RGBC-WS2812B | 5050 SMD J-Lead — cut tape | SELECTED | XL-5050RGBC-WS2812B-ND (https://www.digikey.com/en/products/detail/xinglight/XL-5050RGBC-WS2812B/25673106) | MFR DS (https://www.digikey.com/en/products/detail/xinglight/XL-5050RGBC-WS2812B/25673106) | DK DS (https://www.digikey.com/en/products/detail/xinglight/XL-5050RGBC-WS2812B/25673106) | ~$0.25 | ~$0.22 | In Stock | WS2812B-compatible 5050 SMD. In stock at DigiKey, ships today. Placed on PCB — visible without front panel connected. Powered from 5V_LED rail. First in chain after R_LED_DIN. DOUT feeds LED_DBG2, then continues to J_LED. 628nm Red / 528nm Green / 470nm Blue. 5V nominal, 20mA per channel. | — | — | —
LED_FP | LED_FP | 3 | Addressable RGB LED 5mm TH WS2812B-compatible, diffused — front panel | Various | WS2812B 5mm TH diffused | 5mm TH — AliExpress bulk / Adafruit 1938 fallback | SELECTED | ADA1938 (Adafruit fallback) (https://www.adafruit.com/product/1938) | MFR DS (https://cdn-shop.adafruit.com/datasheets/WS2812B.pdf) | DK DS (https://www.adafruit.com/product/1938) | ~$0.25 | ~$0.20 | AliExpress / Adafruit | WS2812B or SK6812 compatible 5mm TH diffused. Powered from 5V_LED rail at proper spec. Leads bent 90° at ~3mm from body for right-angle board-edge mounting toward front panel. Receives chain from J_LED connector. LED1=charge · LED2=NFC · LED3=fault. Adafruit 1938 (NeoPixel 5mm TH, 5-pack ~$4.95) as verified fallback — may ship WS2812B or SK6812, same protocol. | — | — | —
R24 | R_LED_DIN | 1 | 470Ω ±5% 0603 — LED chain DIN series resistor | Generic | 470Ω 0603 | 0603 — cut tape | SELECTED | — | — | — | ~$0.01 | ~$0.01 | In Stock | Between STM32 GPIO and LED_DBG1 DIN. Protects GPIO, dampens ringing. 300–470Ω acceptable. | — | — | —
8b. ONBOARD DEBUG LEDs — RAIL-DRIVEN (DNP DEFAULT)
⚑ Two single-color LEDs driven directly from power rails — no GPIO, no firmware. Populate during bring-up to verify rails; leave DNP on production boards. LED4: 12V rail → R_LED4 → LED4 → GND. LED5: 3.3V rail → R_LED5 → LED5 → GND.
LED3 | LED3 | 1 | Green LED — 12V rail present (debug, DNP default) | Generic | Green LED 0603 or 3mm TH | 0603 SMD or 3mm TH — singles | DNP | — | — | — | ~$0.05 | ~$0.04 | In Stock | 12V → R27 → LED3 → GND. Vf~2.1V, target 2mA: R=(12-2.1)/0.002=4.95kΩ → use 4.7kΩ. 0603. DNP default. | — | — | —
R27 | R27 | 1 | Current-limit resistor for LED3 — ~4.7kΩ (12V, ~2mA) | Generic | 0603 | 0603 — cut tape | DNP | — | — | — | ~$0.01 | ~$0.01 | In Stock | Rail-driven, no GPIO. Populate with LED3 during bring-up only. | — | — | —
LED4 | LED4 | 1 | Green LED — 3.3V rail present (debug, DNP default) | Generic | Green LED 0603 or 3mm TH | 0603 SMD or 3mm TH — singles | DNP | — | — | — | ~$0.05 | ~$0.04 | In Stock | 3.3V → R28 → LED4 → GND. Vf~2.1V, target 10mA: R=(3.3-2.1)/0.010=120Ω → use 100–150Ω. 0603. DNP default. | — | — | —
R28 | R28 | 1 | Current-limit resistor for LED4 — ~68Ω (3.3V, ~10mA) | Generic | 0603 | 0603 — cut tape | DNP | — | — | — | ~$0.01 | ~$0.01 | In Stock | Rail-driven, no GPIO. Populate with LED4 during bring-up only. | — | — | —
9. USER INTERFACE — BUTTONS
⚑ SW1–SW3: on-PCB 12mm tactile switches for BOOT and RST only. Nav buttons (Up/Down/Sel) route via JST-style 2-pin connectors (J_SW1–J_SW3) to off-board panel buttons — see Section 10. All tactiles: Omron B3F-4050, 12×12mm TH, ships today DK at $0.27. Dual footprint planned: 12mm TH primary (B3F-4050) with overlapping SMD pads (PTS125SM43SMTR2 alt). Both share 6×6mm pin spacing — same footprint, populate one or the other. SMD alt (PTS125SM43SMTR2, ~$0.55) used if board height becomes a constraint at layout time.
SW1 | SW_BOOT | 1 | Tactile switch 12mm TH — BOOT0 DFU | Omron | B3F-4050 | 12×12mm TH — singles | SELECTED | SW262CT-ND (https://www.digikey.com/en/products/detail/omron-electronics-inc-emc-div/B3F-4050/95200) | MFR DS (https://omronfs.omron.com/en_US/ecb/products/pdf/en-b3f.pdf) | DK DS (https://www.digikey.com/en/products/detail/omron-electronics-inc-emc-div/B3F-4050/95200) | ~$0.27 | ~$0.22 | In Stock | Hold + SW_RST → STM32 USB DFU bootloader. PCB-mount only — not routed to panel. B3F-4050: 12×12mm · 7.3mm height · 1.27N · 50mA 24VDC · 3M cycles. Dual footprint: TH primary, SMD alt (PTS125SM43SMTR2) on same 6×6mm pad pattern. | — | — | —
SW2 | SW_RST | 1 | Tactile switch 12mm TH — NRST hard reset | Omron | B3F-4050 | 12×12mm TH — singles | SELECTED | SW262CT-ND (https://www.digikey.com/en/products/detail/omron-electronics-inc-emc-div/B3F-4050/95200) | MFR DS (https://omronfs.omron.com/en_US/ecb/products/pdf/en-b3f.pdf) | DK DS (https://www.digikey.com/en/products/detail/omron-electronics-inc-emc-div/B3F-4050/95200) | ~$0.27 | ~$0.22 | In Stock | Hard reset. PCB-mount only — not routed to panel. Same part and footprint as SW_BOOT. | — | — | —
10. CONNECTORS & TERMINAL BLOCKS
J11 | J_UART | 1 | 4-pin 2.54mm header — UART debug (footprint only, no BOM part) | JST | 4-pin 2.54mm TH | 4-pin 2.54mm TH | SELECTED | — | — | — | — | — | In Stock | Footprint only — no specific part. Populate with any standard 4-pin 2.54mm single-row TH header from parts bin. Pin 1=GND · Pin 2=VCC(3.3V) · Pin 3=TX(PA9/USART1_TX) · Pin 4=RX(PA10/USART1_RX). DNP by default — hand-solder a header for bring-up or field debug as needed. Compatible with standard USB-UART dongles (FTDI, CP2102, CH340 etc) at 3.3V. Footprint at board edge for easy dongle access. | — | — | —
J8 | J_PANEL | 1 | 6-pin XH 2.5mm connector — panel interface (5V, GND, SW1, SW2, SW3, LED_DATA) | JST | JST B6B-XH-A | JST B6B-XH-A | SELECTED | — | — | — | ~$0.15 | ~$0.12 | In Stock | Single connector for all front-panel signals. Pin 1=+5V · Pin 2=GND · Pin 3=GPIO_SW1 · Pin 4=GPIO_SW2 · Pin 5=GPIO_SW3 · Pin 6=LED_DOUT2. XH 2.5mm pitch — robust latching connector, rated 3A. Replaces separate J_LED (3-pin) + J_SW1/J_SW2/J_SW3 (3×2-pin). Mating: XHP-6 housing + SXH-001T-P0.6 crimps. | — | — | —
11. KEY PASSIVES
⚑ Package preference: 0603 preferred for ALL hand-assembled passives including MCU bypass caps. Topside placement within 3-5mm of target pin is acceptable — underside placement is best practice for loop area but not electrically required at 64MHz/3.3V for this application. 0402 retained only where physical density genuinely requires it: bootstrap caps C_BST/C_BST2 (must fit between TSOT-26 IC pins) and RT1 NTC (fits between bleed resistors). 0805 for bulk/high-value caps (10µF, 22µF). TH acceptable for power devices and connectors.
⚑ STM32G0B1CCT6 LQFP48 required passives per AN5096. These are mandatory for correct MCU operation — do not omit. All 0603 topside — underside placement is best practice for loop area minimisation but not required at 64MHz/3.3V. Place within 3-5mm of target pin, GND pad to nearest VSS. VDDA = VDD on this package (shared pin) — no separate VDDA cap needed. No VCAP pins on STM32G0 — internal LDO does not expose VCORE externally.
C10 C11 | C_VDD1 C_VDD2 | 2 | 100nF X7R 10V 0603 — STM32 VDD per-pin bypass | Generic | 0603 | 0603 — cut tape, singles | SELECTED | — | — | — | ~$0.01 | ~$0.01 | In Stock | One 100nF per VDD/VSS pin pair on LQFP48 (2 VDD pins). Topside placement within 3-5mm of each VDD pin. GND pad routed to nearest VSS pin — avoid daisy-chaining through ground pour. Low-ESR X7R ceramic only. Do not substitute Y5V/Z5U. | Device:C | Capacitor_SMD:C_0603_1608Metric | 3-MCU
C13 | C_VBAT | 1 | 100nF X7R 10V 0603 — STM32 VBAT bypass | Generic | 0603 | 0603 — cut tape, singles | SELECTED | — | — | — | ~$0.01 | ~$0.01 | In Stock | VBAT pin tied to VDD (no battery backup used). 100nF bypass still required even when tied to VDD. Topside, close to VBAT pin. SCHEMATIC: VBAT connects to VDD rail via short trace, C_VBAT to GND. | Device:C | Capacitor_SMD:C_0603_1608Metric | 3-MCU
C14 | C_VDDIO2 | 1 | 100nF X7R 10V 0603 — STM32 VDDIO2 bypass | Generic | 0603 | 0603 — cut tape, singles | SELECTED | — | — | — | ~$0.01 | ~$0.01 | In Stock | VDDIO2 independent IO supply — present on STM32G0B1 (G0Bxxx). Tied to VDD (3.3V). 100nF bypass required per AN5096 Fig 2. Topside, close to VDDIO2 pin. | Device:C | Capacitor_SMD:C_0603_1608Metric | 3-MCU
C15 | C_NRST | 1 | 100nF X7R 10V 0603 — STM32 NRST filter cap | Generic | 0603 | 0603 — cut tape, singles | SELECTED | — | — | — | ~$0.01 | ~$0.01 | In Stock | NRST noise filter. 100nF is both minimum AND maximum — do not increase. Larger cap prevents internal reset circuit from driving pin low within spec. No external pull-up on NRST — internal pull-up only. No push-pull drivers — open-drain reset button to GND is correct. Topside, within 10mm of NRST pin. | Device:C | Capacitor_SMD:C_0603_1608Metric | 3-MCU
R10 | R_BOOT0 | 1 | 10kΩ ±5% 0603 — BOOT0/PA14 pull-down | Generic | 0603 | 0603 — cut tape, singles | SELECTED | — | — | — | ~$0.01 | ~$0.01 | In Stock | PA14 is shared SWCLK/BOOT0 on STM32G0. Pull-down holds BOOT0=0 (boot from flash). SW_BOOT button pulls PA14 high momentarily to enter DFU/UART bootloader. Add test point on PA14 net for probe access. FIRMWARE NOTE: set nBOOT_SEL/nBOOT0/nBOOT1 option bytes after first flash to lock boot-from-flash — R_BOOT0 then acts as safety net only. | Device:R | Resistor_SMD:R_0603_1608Metric | 3-MCU
R14 R15 | R_CC1 R_CC2 | 2 | 5.1kΩ ±1% 0603 — USB-C CC pull-downs | Generic | 0603 | 0603 — cut tape, singles | SELECTED | — | — | — | ~$0.01 | ~$0.01 | In Stock | Required for USB-C device (UFP) identification. One per CC pin on J_USB. CC1 and CC2 each pulled to GND via 5.1kΩ — tells host this is a sink device, not a cable or source. Without these the host will not enumerate the device. 5.1kΩ is the correct value for USB 2.0 device with no PD negotiation. Place close to J_USB. GND connection to local DGND pour. | Device:R | Resistor_SMD:R_0603_1608Metric | 3-MCU
⚑ STM32 passives summary: C_VDD1/2 (100nF x2 topside near VDD pins), C_VDD_BULK (4.7uF near MCU), C_VBAT (100nF), C_VDDIO2 (100nF), C_NRST (100nF max), C_VREF (100nF), R_BOOT0 (10k). All 0603 topside. 6 caps + 1 resistor total dedicated MCU passives. C_VREF and C_VDD_BULK listed in general passives section below.
R11 R12 | R_I2C1_SCL R_I2C1_SDA | 2 | 4.7kΩ ±1% 0603 — I2C1 bus pull-ups (SCL + SDA) | Generic | 4.7kΩ ±1% 0603 | 0603 — cut tape | SELECTED | — | — | — | ~$0.01 | ~$0.01 | In Stock | I2C1 sensor bus: INA226(0x40) + PN532(0x24). Pull to 3.3V. Bus runs at 100kHz Standard Mode — tolerant of 6-12" PN532 cable (~30-90pF added capacitance). At 100kHz: Rmax = 1000ns/(0.847×140pF) = 8.4kΩ — 4.7kΩ well within spec with full cable worst case. ⚑ PN532 module may have its own pull-ups — verify at schematic. If so, these can be DNP (parallel = 2.35kΩ, still OK). Always fitted regardless of display choice. | — | — | —
R25 R26 | R25 R26 | 2 | 4.7kΩ ±1% 0603 — I2C2 bus pull-ups (SCL + SDA) — DNI for SPI display | Generic | 4.7kΩ ±1% 0603 | 0603 — cut tape | DNI | — | — | — | ~$0.01 | ~$0.01 | In Stock | I2C2 display bus: PB10/PB11. Pull to 3.3V. DNI (Do Not Install) when SPI display is fitted — I2C2 bus unused, pull-ups waste power. Install only if I2C display (e.g. SSD1306) is chosen for J_DISP. Bus runs at 400kHz Fast Mode — short PCB traces only, no cable. At 400kHz with ~50pF trace+device: Rmax = 300ns/(0.847×50pF) = 7.1kΩ — 4.7kΩ within spec. Footprint always present on PCB — populate at assembly time based on display choice. | — | — | —
FB1 | FB1 | 1 | Ferrite bead 600Ω@100MHz 0603 — power common to INA226 AGND island | Murata | BLM18KG601SN1D | 0603 — cut tape, singles | SELECTED | 490-5258-1-ND (https://www.digikey.com/en/products/detail/murata-electronics/BLM18KG601SN1D/1982781) | MFR DS (https://www.murata.com/en-us/products/productdetail?partno=BLM18KG601SN1D) | DK DS (https://www.digikey.com/en/products/detail/murata-electronics/BLM18KG601SN1D/1982781) | ~$0.10 | ~$0.08 | In Stock | GROUND TOPOLOGY: CHG−/BAT−/PE form large copper common (heavy traces, full battery current). DGND pour connects directly to this common — no ferrite in digital return path. FB1 branches from this common to small AGND island containing ONLY INA226 GND pin (pin 7). INA226 VBUS (pin 8) and IN− sense trace also reference AGND island. FB1 carries only INA226 quiescent current (~330µA) — drop = 50µV across 150mΩ DCR. Negligible. Ferrite at full rated 600Ω@100MHz — no saturation at this current. Isolates INA226 GND from HF noise on DGND (buck switching, relay, LEDs, STM32). LAYOUT: AGND island small and tight around INA226 only — no other components on AGND. FB1 placed near CHG−/BAT− star point. Single connection between AGND island and power common. | Device:Ferrite_Bead | Inductor_SMD:L_0603_1608Metric | 3-MCU
R13 R29 R30 R31 | R_NTC_S R29 R30 R31 | 4 | 100Ω ±5% 0603 — ADC input series protection | Generic | 0603 pref | 0603 pref — cut tape, singles | GENERIC | — | — | — | ~$0.01 | ~$0.01 | In Stock | Series resistor on each ADC input line to STM32. Limits fault current if input exceeds VDD. R_NTC_S: NTC thermistor line (always fitted). R_CHG_S/R_12V_S/R_BAT_S: voltage divider outputs (DNP with their dividers). 100Ω same value as R_LED_DIN — one value to stock. | Device:R | Resistor_SMD:R_0603_1608Metric | 3-MCU
R18 R20 R16 | R_CHG_H R_12V_H R_BAT_H | 3 | 100kΩ ±1% 0603 — ADC voltage divider top (CHG+, 12V, BAT+) — DNP default | Generic | 0603 pref | 0603 pref — cut tape, singles | GENERIC | — | — | — | ~$0.01 | ~$0.01 | In Stock | Top resistor of 3 identical voltage dividers. All DNP by default — populate as needed. Divider: 100kΩ + 18kΩ → safe to 20V input (20V→3.05V, within 3.3V ADC). R_CHG_H: CHG+ → monitors charger voltage presence and level. R_12V_H: 12V rail → confirms rail health, detects brownout. R_BAT_H: BAT+ → redundant battery voltage if INA226 comms fails. 100kΩ same value as R_I2C pull-ups — one value to stock. | Device:R | Resistor_SMD:R_0603_1608Metric | 3-MCU
R19 R21 R17 | R_CHG_L R_12V_L R_BAT_L | 3 | 18kΩ ±1% 0603 — ADC voltage divider bottom (CHG+, 12V, BAT+) — DNP default | Generic | 0603 pref | 0603 pref — cut tape, singles | GENERIC | — | — | — | ~$0.01 | ~$0.01 | In Stock | Bottom resistor of 3 identical voltage dividers. All DNP by default — populate with top resistors. 100kΩ + 18kΩ: ratio = 18/118 = 0.153. At 20V → 3.05V ✓. At 13.2V (full FRC battery) → 2.01V ✓. Divider current at 20V: 20V/118kΩ = 170µA — negligible. ⚑ LAYOUT: C_ADC_BYPASS 100nF on each divider midpoint to GND recommended at schematic capture. | Device:R | Resistor_SMD:R_0603_1608Metric | 3-MCU
R6 | R_GATE_K1 | 1 | 1kΩ ±5% — relay NPN base resistor | Generic | 0603 pref | 0603 pref — cut tape, singles | GENERIC | — | — | — | ~$0.01 | ~$0.01 | In Stock | Base resistor for Q2 NPN relay coil driver. 0603 or larger, TH acceptable. | Device:R | Resistor_SMD:R_0603_1608Metric | 3-MCU
C_BYP | C_BYP | ~20 | 100nF ±10% X7R 10V — VCC decoupling | Generic | 0603 pref | 0603 pref — cut tape, singles | GENERIC | — | — | — | ~$0.01 | ~$0.01 | In Stock | One per VCC/supply pin throughout board. Qty updated: STM32 VDD×2, VDDA, VREF+, VBAT, VDDIO2, NRST, INA226 VCC, LDO, 5V_LED rail, ADC divider midpoints. Exact qty confirmed at schematic capture. 0603 preferred, 0402 acceptable where density requires. Low-ESR ceramic only. | Device:C | Capacitor_SMD:C_0603_1608Metric | 3-MCU
C18 | C_BULK_3V3 | 1 | 10µF ±20% X5R ≥6.3V — 3.3V rail bulk bypass | Generic | 0805 pref | 0805 pref — cut tape, singles | GENERIC | — | — | — | ~$0.05 | ~$0.04 | In Stock | Near MCU load, not at regulator output. 0805 preferred. | Device:C | Capacitor_SMD:C_0603_1608Metric | 3-MCU
C12 | C_VDD_BULK | 1 | 4.7µF ±20% X5R ≥6.3V 0805 — STM32 VDD package bulk cap | Generic | 0805 pref | 0805 pref — cut tape, singles | GENERIC | — | — | — | ~$0.05 | ~$0.04 | In Stock | Per AN5096: one bulk ceramic cap per package for STM32G0. Place near MCU, separate from C_BULK_3V3. Low-ESR ceramic. 0805 preferred. | Device:C | Capacitor_SMD:C_0603_1608Metric | 3-MCU
C16 | C_VREF | 1 | 100nF ±10% X7R 10V 0603 — STM32 VREF+ bypass | Generic | 0603 pref | 0603 pref — cut tape, singles | GENERIC | — | — | — | ~$0.01 | ~$0.01 | In Stock | VREF+ tied to VDDA (VDD). 100nF bypass only — no 1µF needed since VREFBUF disabled. Per AN5096. Topside, close to VREF+ pin. | Device:C | Capacitor_SMD:C_0603_1608Metric | 3-MCU
12. OPTIONAL DISPLAY EXPANSION
⚑ J_DISP 10-pin header supports I2C or SPI displays. Populate one of the options below — or none. I2C option: 4 pins used (VCC/GND/SCL/SDA). SPI option: all 10 pins. Backlight (BL) on PB15 supports PWM dimming via TIM1_CH3N. I2C2 bus is dedicated to display — independent from I2C1 (INA226/PN532).
DISP1 (opt A) | DISP1 (opt A) | 1 | OLED I2C 128×64 0.96" SSD1306 — I2C option (no backlight) | Various | SSD1306 0.96" 4-pin I2C module | Module — AliExpress single | GENERIC | — | — | — | ~$1.50 | ~$1.20 | AliExpress | I2C addr 0x3C on I2C2 bus (PB10/PB11). No backlight pin — self-emitting OLED. 4 pins used on J_DISP (VCC/GND/SCL/SDA). pins 5–10 unconnected. No conflicts: I2C1 carries INA226(0x40)/PN532(0x24). I2C2 is display-only. | — | — | —
DISP1 (opt B) | DISP1 (opt B) | 1 | TFT LCD SPI color display 0.96"–1.8" with backlight — SPI option | Various | SPI TFT module (ST7735/ILI9341 etc) | Module — AliExpress single | GENERIC | — | — | — | ~$2.50 | ~$2.00 | AliExpress | SPI2 on PB9–PB13. BL on PB15 (PWM dimming). DC on PB13. RST on PB14. Typical pinout: VCC·GND·SCK(PB10)·MOSI(PB11)·MISO(PB9)·CS(PB12)·DC(PB13)·RST(PB14)·BL(PB15). Confirm module pinout before wiring — varies by vendor. Example: AliExpress item 1005008974306385 (~$3.70 color TFT with BL). | — | — | —

Sheet: Bay Module BOM
FRC Battery Monitor — Bay Module BOM (Rev 0.1 · April 2026) One complete bay = assembled PCB + NFC module + cable. Install N per cart.
Ref Des | Friendly Name | Qty | Description | Manufacturer | MPN | Package / Ordering note | Status | DigiKey / Order PN | MFR Datasheet | DK Datasheet | Price 1x | Price 10x | Stock | Notes / Design Requirements | KiCad Symbol | KiCad Footprint | Sch Page
Ordering policy: Packaging type (tube/cut tape/bulk) not relevant — priority is lowest per-unit cost at qty 1–10 for manual assembly. DigiKey cut tape / MouseReel / AliExpress singles all acceptable. Avoid full-reel minimums. Prices marked CHECK must be verified live — subject to tariffs.
1. COMPLETED PCB ASSEMBLY
PCB1 | PCB1 | 1 | Bay Control PCB — fully assembled and tested (see Bay PCB BOM for components) | In-house | FRC-BATT-BAY-PCB-v0.1 | Assembled board | SELECTED | N/A | — | — | — | — | In-house build | All components per Bay PCB BOM tab. Program STM32 via SWD before installation. Test USB CDC comms and I2C bus continuity before fitting to cart. | — | — | —
2. NFC MODULE
MOD1 | MOD1 | 1 | NFC reader module — PN532 clone, I2C mode, reads UID on battery | Generic (Chinese clone) | PN532 NFC Module (V3-compatible) | Module — AliExpress, buy 1–2 spares per bay | SELECTED | AliExpress — see link (https://www.aliexpress.us/item/2251832698472831.html) | MFR DS (https://www.nxp.com/docs/en/user-guide/141520.pdf) | DK DS (https://www.elechouse.com/elechouse/images/product/PN532_module_V3/PN532_%20Manual_V3.pdf) | ~$3 | ~$2.50 | AliExpress stock | V3-compatible clone — validated in prototyping. Same NXP PN532 chip, pinout, libraries. Set I2C mode: SW1=ON SW2=OFF. I2C addr 0x24. IRQ → STM32 GPIO. No FCC/CE cert — acceptable for internal FRC tool. ⚑ ~$3 realistic unit price (intro/sale pricing can show ~$1 — do not use as budget figure). Buy 1–2 spares per bay. All V3 on market are clones (Elechouse stopped V3 production 2017). | — | — | —
3. WIRING & MECHANICAL
CBL1 | CBL1 | 1 | NFC module cable — 5-wire, SDA SCL IRQ VCC GND, ~150mm | Generic | — | Hardware — order singles or small pack | GENERIC | — | — | — | ~$0.10 | ~$0.08 | Hardware store / Amazon | Dupont or JST-XH 5-pin pre-crimped. Length to suit bay enclosure depth. | — | — | —
STND1–4 | STND1–4 | 4 | PCB standoffs — 5mm M3 nylon (for bleed resistor horizontal mount) | Generic | — | Hardware — order singles or small pack | GENERIC | — | — | — | ~$0.10 | ~$0.08 | Hardware store / Amazon | Nylon M3×5mm standoffs. Two per bleed resistor, four per board. | — | — | —
STND5–8 | STND5–8 | 4 | PCB standoffs — M3 for board-to-enclosure mounting | Generic | — | Hardware — order singles or small pack | GENERIC | — | — | — | ~$0.10 | ~$0.08 | Hardware store / Amazon | Height TBD based on enclosure. Metal or nylon. | — | — | —
HW1 | HW1 | 1 | M3 screws and nuts — mounting hardware | Generic | — | Hardware — order singles or small pack | GENERIC | — | — | — | ~$0.10 | ~$0.08 | Hardware store / Amazon | Qty TBD at mechanical design. | — | — | —

Sheet: Robot Cart BOM
FRC Battery Monitor — Robot Cart System BOM (Rev 0.1 · April 2026) Full cart assembly. N = number of bays (typically 4–8). Adjust qty column for your bay count.
Ref Des | Friendly Name | Qty | Description | Manufacturer | MPN | Package / Ordering note | Status | DigiKey / Order PN | MFR Datasheet | DK Datasheet | Price 1x | Price 10x | Stock | Notes / Design Requirements | KiCad Symbol | KiCad Footprint | Sch Page
Cart BOM note: Set N = number of bays required. Prices for chargers/Pi are approximate — verify current pricing before ordering. Cart hardware (enclosure, wiring, cable management) is to be specified at mechanical design phase.
1. BAY MODULES (×N — one per charging bay)
MOD1–N | MOD1–N | N | Bay monitor module — assembled PCB + PN532 + cable (see Bay Module BOM) | In-house | FRC-BATT-BAY-MOD-v0.1 | Assembled module — in-house | SELECTED | N/A | — | — | — | — | In-house build | Each module = 1× Bay Control PCB (assembled) + 1× PN532 NFC clone + cable. See Bay Module BOM tab for full breakdown. Build and test before cart installation. | — | — | —
2. BATTERY CHARGERS (×N — one per bay)
CHG1–N | CHG1–N | N | FRC battery charger — NOCO Genius5 or NOCO Genius10 (one per bay) | NOCO | GENIUS5 or GENIUS10 | Retail box — Amazon / NOCO direct | SELECTED | GENIUS5 / GENIUS10 (https://no.co/genius5) | MFR DS (https://no.co/genius5) | — | ~$35–50 | ~$30–45 | Amazon / NOCO | NOCO Genius5: 5A max, ~$35. NOCO Genius10: 10A max, ~$50. One per bay. Output feeds J_CHG on bay board. Charger negative is common-referenced to cart ground terminal block. | — | — | —
3. RASPBERRY PI HOST
PI1 | PI1 | 1 | Raspberry Pi — host controller for all bay boards | Raspberry Pi Foundation | Raspberry Pi 4B 2GB or 4GB | Retail — Adafruit / Vilros / PiShop | SELECTED | Raspberry Pi 4B (https://www.raspberrypi.com/products/raspberry-pi-4-model-b/) | MFR DS (https://datasheets.raspberrypi.com/rpi4/raspberry-pi-4-datasheet.pdf) | — | ~$35–55 | — | In stock (various) | Runs orchestration, logging, UI. Connected to all bay boards via USB hub. Powered independently by USB wall adapter. 4GB recommended if running local database + web UI simultaneously. | — | — | —
PI_PSU1 | PI_PSU1 | 1 | Raspberry Pi USB-C power supply — 5V 3A official | Raspberry Pi Foundation | SC0218 or equiv | Retail | SELECTED | SC0218 (https://www.raspberrypi.com/products/27w-power-supply/) | — | — | ~$12 | — | In stock | Official Pi USB-C supply. 27W recommended for Pi 5, 15W sufficient for Pi 4. | — | — | —
PI_SD1 | PI_SD1 | 1 | MicroSD card — Pi OS + battery log storage, 32GB+ Class 10 | Generic | 32GB+ Class 10 / A1 microSD | Retail | GENERIC | — | — | — | ~$8 | ~$6 | Amazon | Samsung Endurance Pro recommended for write-heavy logging applications. | — | — | —
4. USB HUB
HUB1 | HUB1 | 1 | Self-powered USB hub — N+1 ports minimum, for bay boards + Pi peripherals | Generic | 7-port or 10-port USB-A self-powered hub | Retail — Amazon | GENERIC | — | — | — | ~$20–35 | — | Amazon | Must be self-powered (own wall adapter) — not bus-powered. Needs at least N ports for bay boards plus 1–2 for Pi peripherals. Candidates: Anker 10-port powered hub (~$30). | — | — | —
5. POWER DISTRIBUTION
STRIP1 | STRIP1 | 1 | Power strip — cart internal AC distribution, surge protected | Generic | 6–8 outlet surge protected power strip | Hardware store / Amazon | GENERIC | — | — | — | ~$15–25 | — | Hardware store | Bonded to cart wall — becomes PE reference for all bay grounds. Outlets: N chargers + 12V supply + Pi adapter + hub adapter. Size accordingly. | — | — | —
PSU_12V | PSU_12V | 1 | 12V DC supply — powers all bay boards via J_CHG JP1 or dedicated rail | TBD | 12V 5A+ DIN rail or wall-mount supply | Retail / DigiKey | TBD | — | — | — | ~$15–30 | — | DigiKey / Amazon | Powers all bay board 12V rails. 1A per bay minimum. Candidates: Mean Well DR-60-12 (DIN rail, 12V 4.5A, ~$20). | — | — | —
TB1 | TB1 | 1 | Ground terminal block — common PE reference for all bay grounds | Generic | DIN rail terminal block strip or bus bar | DigiKey / hardware | GENERIC | — | — | — | ~$5–10 | — | DigiKey | Mounted to cart wall. All CHG−, BAT−, and PE wires terminate here. Bonded to cart wall (PE) and power strip ground. | — | — | —
6. CART ENCLOSURE & MECHANICAL
CART1 | CART1 | 1 | Metal utility cart — houses all equipment | Generic | TBD | TBD | TBD | — | — | — | TBD | TBD | TBD | Standard 3-shelf metal cart. Size TBD. Steel preferred for PE bonding. | — | — | —
ENC1–N | ENC1–N | 1 | Bay enclosure / bracket — mounts PCB and PN532 per bay | Generic | TBD | TBD | TBD | — | — | — | TBD | TBD | TBD | Mechanical design TBD. Must allow NFC antenna access to battery bottom. | — | — | —
WIRE1 | WIRE1 | 1 | Wire harness — inter-bay wiring, ground runs, CHG wiring | Generic | TBD | TBD | TBD | — | — | — | TBD | TBD | TBD | 18 AWG minimum for power lines. Home-run from each bay to ground block. No daisy-chain. | — | — | —
CBL_USB1–N | CBL_USB1–N | 1 | USB-A to USB-C cables — bay board to hub (one per bay) | Generic | TBD | TBD | TBD | — | — | — | TBD | TBD | TBD | 0.5m. USB 2.0 minimum. Right-angle USB-C at board end preferred. | — | — | —

Sheet: Design Decisions
Design Decisions & Requirements Log — FRC Battery Monitor (all assemblies)
# | Area | Decision / Requirement | Rationale | Status
1 | System | N bay modules connect via USB to Raspberry Pi through a self-powered USB hub. | Modular, scalable. Each bay independent — Pi reboot doesn't disrupt charging. | DECIDED
2 | System | Bay board: autonomous monitoring, NFC on insertion, LED state, OCV test on Pi command, fault detection. | Simple firmware, reliable local operation without Pi dependency. | DECIDED
3 | System | Pi: orchestration, test mode, telemetry logging, removal polling, UI, buzzer, battery history. | Separates real-time control from higher-level application logic. | DECIDED
4 | Power | 12V primary → AP63203WU-7 buck → 3.3V rail. No intermediate 5V rail. Board is 3.3V only. | Buck handles 3.8–32V input directly to 3.3V. Simpler than two-stage. FSS reduces EMI. | DECIDED
5 | Power | USB VBUS fallback → MIC5219 LDO → 3.3V. Active only when 12V absent. USB always connected to Pi for CDC. | MIC5219 chosen over AP2112K: AP2112K has active auto-discharge that would fight buck rail on startup. MIC5219 shuts down passively — safe to share the same 3.3V rail. | DECIDED
6 | Power | U5 mux, Q_PG transistor, and R_EN all eliminated. AP63203 PG pin → R_PG 100kΩ → MIC5219 EN. Direct connection. | PG low (12V healthy) = EN low = LDO off. PG high-Z (12V absent) = EN pulled high via R_PG = LDO on. Works because MIC5219 EN is active-high and PG is active-low — logic maps directly without inversion. | DECIDED
7 | Power | JP1 optional jumper bridges CHG+ into 12V rail when no dedicated 12V supply fitted. | Allows charger to power board during prototyping. | DECIDED
8 | Power | AP2112K-3.3TRG1 REJECTED for U4 — has active auto-discharge on EN low. | Auto-discharge would pull 3.3V rail toward GND during buck startup while both regulators share rail. MIC5219 has no discharge circuit — shuts down passively, safe for shared-rail OR-ing. | DECIDED
9 | Power | L1 = Bourns SRR4028-3R9Y 3.9µH shielded. Correction: AP63203 Table 2 specifies 3.9µH not 4.7µH (4.7µH is AP63205 5V variant). | At ~200mA real load, peak inductor current ≈0.48A — well within 1.72A Irms rating. DCR 60mΩ < 100mΩ limit. | DECIDED
10 | Power | C_IN = 10µF X5R 25V 0805. C_OUT = 22µF X5R 6.3V 0805. C_BST = 100nF X7R 10V 0402 — all per AP63203 Table 2. | C_BST between BST and SW is required — bootstrap undervoltage protection triggers at 2.3V. All ceramic MLCC low ESR. | DECIDED
11 | Ground | Single PE reference. Dedicated PE wire from each bay to common terminal block on cart wall. | Cart wall + power strip earth = single defined reference. No USB isolator needed. | DECIDED
12 | Ground | All CHG− and BAT− run dedicated home-run wires to common ground terminal block. No daisy-chain. | Eliminates ground reference uncertainty from daisy-chain resistance. | DECIDED
13 | Ground | Ferrite bead on PCB between power GND and digital GND areas. DC reference is common. | HF noise filter only — prevents switching transients coupling into ADC. | DECIDED
14 | Switching | SPDT relay K1 (Omron G5LE-1 DC3). NC=CHG+ (fail-safe at rest). NO=bleed load path top. COM=BAT+ rail. | SPDT sufficient — Q3 N-FET handles load gating independently. Simpler, cheaper, smaller than DPDT. | DECIDED
15 | Switching | 3V rated coil (G5LE-1 DC3). Q2 NPN driven from 3.3V rail. No 5V rail on board. | 3V coil must-operate = 2.25V. 3.3V rail well above threshold. GPIO drives Q2 base only (~1mA). | DECIDED
16 | Switching | Q3 N-FET low-side gates bleed load independently of relay position. | Relay switches CHG vs load path. Q3 enables/disables current flow in load path separately. | DECIDED
17 | Switching | INA226 shunt on BAT+ before relay COM. Continuous bidirectional monitoring in all states. | +ve=charging, −ve=load test, ≈0=OCV float. Rich telemetry without switching sensor. | DECIDED
18 | Measurement | INA226AQDGSRQ1 (VSSOP-10) + external 10mΩ shunt (WSL2512R0100FEK18 2512). | 57% cheaper than INA260 ($3.10 total vs $5.58). 5× better resolution (250µA vs 1.25mA LSB). 5.6M DK stock, tube pkg active. 10mΩ: 5A→50mV within ±81.92mV INA226 limit. | DECIDED
19 | Measurement | INA260 REJECTED — tube variant obsolete, T&R lead time risk, $5.58 vs $3.10 total. | INA226 wins on cost, availability, resolution, and shunt value flexibility. | DECIDED
20 | Measurement | Kelvin routing required for R_SHUNT: sense traces to INA226 IN+/IN− at inner pad edges. | Prevents lead/trace resistance adding to shunt reading. Zero cost if planned at layout. | DECIDED
21 | Protection | Fuses on all three 12V inputs. ATM mini blade — same format as REV PDH low-current channels. Teams have spares. | Sizing provisional: F1 BAT+ and F2 CHG+ = 7.5A, F3 12V rail = 2A. 7.5A blows fast on real fault, tolerates short inrush. 2A on low-current 12V rail. All easily swappable. MPD BK-6013 PCB through-hole holder — compact body, ~$0.65 DK single vs ~$1.20 Keystone 3568. One footprint for all three positions. | DECIDED
22 | Protection | Q1 = AO3401A P-FET. Vds −30V, Id −4.0A steady-state, Vgs(th) max −1V, RDS(on) < 50mΩ. | Reverse polarity: gate=GND → Vgs=0 → FET off. Normal op: Id peak ~6.8A but short duty cycle only during bleed test. F1 fuse provides primary overcurrent protection. DMG2305UX rejected — Vds −20V too tight vs 14.4V max. | DECIDED
23 | Protection | Q3 = IRFZ44NPBF (TO-220 TH primary) / IRFZ44NSPBF (D2PAK SMD alt). Dual footprint on PCB. | Standard-threshold N-FET driven at 10–12V via Q3_DRV NPN stage (MMBT2222A + R_B3 4.7kΩ + R_G3 100Ω). RDS(on) = 17.5mΩ fully guaranteed at 10V spec — no 3.3V derating uncertainty. At 1.82A nominal: P = 0.058W, TJ rise < 4°C in free air — no heatsink required. Total Q3 position cost: FET $1.39 + driver $0.07 = $1.46, cheaper than IRLZ44NPBF ($1.78) alone. GPIO logic inverted (HIGH = off, LOW = on) — handled in firmware with invert flag. AO3400A rejected: Vds only 30V = exactly 2× battery max, no margin. IRLZ44NPBF rejected: more expensive, 3.3V gate gives unguaranteed higher RDS(on). | DECIDED
24 | Thermal | RT1 = TDK NTCG103JF103FT1. 10kΩ NTC, 0402, B25/85 = 3380K. | 0402 fits between bleed resistor bodies. Same B-constant as 0603 sibling — firmware identical. $0.10 ea, 559K DK stock. NCP18XH103F03RB (Murata 0603) rejected — larger package, higher cost. | DECIDED
25 | Bleed | Two × 3.3Ω in series = 6.6Ω total (~1.8A at 12V). Dual footprint: SQP500 and SQP10A. | Series pair shares heat. Dual footprint allows 5W or 10W without redesign. | DECIDED
26 | Bleed | Dual footprint: shared inner pad, 1.0mm drill, 5mm standoffs, silkscreen both outlines. | Zero cost design decision — either part fits without PCB change. | DECIDED
27 | MCU | STM32G0B1CCT6 — LQFP48 7×7mm 0.5mm pitch 256KB flash crystal-less USB FS 64MHz Cortex-M0+. | Right-sized for one bay. 37 usable GPIO, 25 committed, 12 spare. Smaller than LQFP64 (7×7 vs 10×10mm) — better PCB placement. Same silicon, same firmware as RCT6. LQFP64 RCT6 rejected: 24 excess GPIO, larger footprint, ~$0.70 more expensive per unit. LQFP32 rejected: essentially zero GPIO margin even with LED muxing, 0.8mm pitch harder to hand-assemble in proto qty. | DECIDED
28 | Comms | All ICs share a single I2C bus. Verified address map: INA226 (0x40–0x4F via A0/A1), PN532 (0x24), SSD1306 LCD (0x3C). | No address conflicts confirmed. INA226 A0=A1=GND → 0x40. PN532 fixed at 0x24 in I2C mode. SSD1306 fixed at 0x3C. No SPI needed. Two GPIO pins (SDA/SCL) serve all three devices. Pull-ups to 3.3V on bus. | DECIDED
29 | Comms | Pi communicates with each bay STM32 via USB CDC (USB Full Speed). Pi is NOT connected via UART or SPI. | STM32G0B1 USB FS device on PA11/PA12 — crystal-less, no external oscillator needed. Each bay appears as a CDC serial port on the Pi via the self-powered USB hub. No UART/SPI GPIO consumed for Pi comms — those pins are free for other use. | DECIDED
30 | NFC | PN532 V3-compatible clone (AliExpress ~$3) in I2C mode via DIP switch. Validated in prototyping. | Same NXP PN532 chip/pinout/libraries. FCC/CE not required for internal FRC tool. Buy spares ~$3 each. All V3 on market are clones — Elechouse stopped V3 in 2017. | DECIDED
31 | GPIO | STM32G0B1CC LQFP48: ~37 usable GPIO. 17 pins committed, ~20 spare. | Committed: USB 2 (PA11/PA12 fixed), I2C 2, SWD 2 (PA13/PA14 fixed), VBUS sense 1, NTC ADC 1, relay driver 1, Q3_DRV 1, Q1 gate 1, INA226 ALERT 1, buttons 4, LED chain 1 = 17 committed. ~20 spare — comfortable. Addressable LED chain uses 1 GPIO vs 9 for direct RGB — 8 GPIOs freed. Display header (J_DISP): PB9–PB15 = 7 more committed if display fitted (optional, not in base budget). | DECIDED
32 | LEDs | WS2812B addressable RGB chain — 5 LEDs total on 1 GPIO, powered from dedicated 5V_LED rail. | Chain: STM32 GPIO → 470Ω → LED_DBG1(SMD,PCB) → LED_DBG2(SMD,PCB) → J_LED → LED1/2/3(5mm TH front panel). SMD debug LEDs: XL-5050RGBC-WS2812B, DigiKey, $0.25 ea, ships today. Front panel LEDs: WS2812B/SK6812 5mm TH, AliExpress ~$0.25 ea, Adafruit 1938 fallback. 5V_LED rail: AP63205 buck (12V→5V) + Schottky diode OR from VBUS — LEDs work when Pi is off. WS2812B runs at proper 5V spec — no compromise, no level shifter workaround needed. Extensible: J_LED carries 5V/GND/DATA to front panel — add LEDs in firmware only. | DECIDED
33 | Power | 5V_LED rail: AP63205WU-7 buck (12V→5V, 2A) + MBR0530 Schottky, OR-ed with VBUS via second MBR0530. | LEDs operate whenever 12V OR USB present — including when Pi is off or hasn't booted. AP63205 same family/footprint as U3(AP63203) — identical passives, same PCB footprint. 2A rating = 6× worst-case LED draw (324mA). Efficient buck vs LDO: 0.28W vs 2.3W at full load. MBR0530 Schottky: 30V 500mA SOD-123, $0.14. Prevents backfeed between sources. WS2812B VDD spec 3.5–5.3V — 5V_LED rail delivers ~4.65V after diode drop at full load. Within spec. | DECIDED
34 | LEDs | LED state map: LED1=charge(Red=charging, Amber=bleed, Green blink=ready). LED2=NFC(Blue blink=reading, Blue=OK, Red blink=fail). LED3=fault(Red blink). | All colors and blink patterns in firmware. Chain extensible — future LEDs added without hardware changes. Green blink covers both empty bay and charge complete — both mean available. | DECIDED
35 | INA226 | A0=GND, A1=GND → I2C address 0x40. Direct GND tie, no resistors. | 0x40 is default address, avoids any address conflict with PN532 (0x24). A0/A1 sampled on every I2C transaction — must be stable before communication. | DECIDED
36 | INA226 | ALERT pin: STM32 internal pull-up (40kΩ typ). No external R_ALERT needed. | ALERT is open-drain active-low. STM32 internal pull-up adequate — 82µA sink current at 40kΩ, well within INA226 10mA IOUT max. STM32 GPIO falling-edge interrupt. Configurable via Mask/Enable (0x05) and Alert Limit (0x06) registers. | DECIDED
37 | INA226 | VBUS pin: C_VBUS 100nF 25V DNP footprint. No filter needed in normal operation. | Battery bulk capacitance suppresses charger switching ripple adequately in normal use. Charger designed to run unloaded — no voltage excursion risk when no battery present. Relay NC fail-safe makes board transparent to charger when MCU off — intentional design. DNP footprint available to populate if VBUS ripple causes measurement noise at bring-up. | DECIDED
38 | Connectors | J_PWR_A: OSTYK42105030 barrier block, 5-pos 8.26mm. BAT+/BAT−/CHG+/CHG−/PE. | BAT−/CHG−/PE all tie to large copper common at connector — zero routing needed for common node. 20A/300V rated, 12-22AWG, screws with captive plate — accepts ring terminals or bare wire. SB50 pigtails (16AWG ~6") terminate with crimped ring terminals. DK: ED2942-ND, ~$1.67. | DECIDED
39 | Connectors | J_PWR_B: OSTYK42102030 barrier block, 2-pos 8.26mm. 12V+/12V−. | Physically separated from J_PWR_A — located near U3 buck converter. Keeps 12V supply routing in buck zone, away from high-current BAT/CHG area. Same OSTYK42 series — one KiCad footprint covers both blocks. DK: ED2940-ND, ~$0.80. | DECIDED
40 | I2C | I2C1 at 100kHz Standard Mode — tolerant of 6-12" PN532 cable. 4.7kΩ pull-ups always fitted. | At 100kHz: Rmax = 8.4kΩ at worst-case 140pF (50pF PCB + 90pF 12" cable). 4.7kΩ well within spec. PN532 module may have on-board pull-ups — verify at schematic. If present, parallel = 2.35kΩ, still OK at 100kHz. No performance reason to run sensor bus faster — INA226 polling and NFC reads are slow operations. | DECIDED
41 | I2C | I2C2 at 400kHz Fast Mode — display bus, short PCB traces only. Pull-ups DNI for SPI display. | R_I2C2_SCL/SDA footprints present on PCB but DNI when SPI display fitted (I2C2 unused). Install only if I2C display (SSD1306 etc) chosen at J_DISP. At 400kHz with ~50pF trace: Rmax = 7.1kΩ — 4.7kΩ within spec. | DECIDED
42 | Grounding | CHG−/BAT−/PE: large copper common, heavy traces, full battery current. Board true earth reference. | CHG−, BAT−, and PE chassis connection all bonded on wide copper — this is the power ground. Not a signal ground — carries full charge/discharge current. | DECIDED
43 | Grounding | DGND pour: connects directly to CHG−/BAT−/PE common. No ferrite in digital return path. | All digital returns (STM32, buck converter, LDO, LEDs, relay) reference DGND pour. DGND joins power common directly at star point near CHG−/BAT− terminals. | DECIDED
44 | Grounding | AGND island: small copper area around INA226 GND pin only. Connected to power common via FB1. | INA226 GND (pin 7), VBUS (pin 8), and IN− sense trace reference AGND island. No other components on AGND. Single connection to power common via FB1 only. FB1 carries only INA226 quiescent ~330µA — 50µV drop across 150mΩ DCR. Keeps INA226 reference quiet from HF noise on DGND. | DECIDED
45 | ADC | 4 STM32 ADC channels: NTC (always fitted), CHG+ voltage, 12V rail, BAT+ voltage (all 3 DNP default). | NTC: direct with 100Ω series (R_NTC_S). CHG+/12V/BAT+: 100kΩ+18kΩ divider, safe to 20V (20V→3.05V, 13.2V→2.01V). All dividers DNP by default — populate as needed without hardware changes. BAT+ divider: redundant fallback if INA226 I2C comms fails. CHG+ divider: charger presence and voltage level. 12V divider: rail health monitoring. VREF+ tied to VDDA — adequate for NTC temperature (±2°C acceptable) and voltage threshold detection. | DECIDED
46 | ADC | VREF+ tied to VDDA (VDD). VREFBUF disabled. 100nF bypass only on VREF+ pin. | ADC only used for NTC thermistor and voltage dividers — loose accuracy requirements. No precision reference IC needed. No 1µF cap needed (only required when VREFBUF enabled). Simplifies BOM and firmware — no VREFBUF initialization required. | DECIDED
47 | Transistors | Q1 AO3401A P-FET gate: R_G1 10kΩ to GND. Always-on series guard — no switching, no drive resistor needed. | Gate tied to GND, source = BAT+ → Vgs always negative → FET conducts. R_G1 prevents floating gate at power-up and provides ESD discharge path. 10kΩ same value as R_BOOT0 — one stocked value covers both. | DECIDED
48 | Transistors | Q2 IRFZ44N (load FET) gate driven by Q3 (NPN). R4 100kΩ pull-down on Q3 base — holds Q3 off at boot, keeping Q2 gate low. Correct intervention point is Q3 base not Q2 gate. | Without pull-down: GPIO floating during STM32 boot → Q3_DRV indeterminate → Q3 gate may float → bleed resistors could partially enable. R_BOOT_G3 clamps gate to GND during boot. 100kΩ negligible vs R_G3 (100Ω) from 12V in on-state — gate still reaches ~12V. Same value as ADC divider top resistors — one stocked value. | DECIDED
49 | Thermal | Single NTC per bay, co-located between bleed resistors. No NTC on battery terminal. | Bleed resistor is only real heat source. Battery terminal NTC has marginal value. | DECIDED
50 | UI | SW_BOOT + SW_RST: Omron B3F-4050 12mm TH tactile, $0.27, DK ships today. Dual footprint with PTS125SM43SMTR2 SMD alt. | 12×12mm body · 6×6mm pin spacing · 7.3mm height · 1.27N · 50mA 24VDC · 3M cycles. Both TH (B3F-4050) and SMD alt (PTS125SM43SMTR2, 4.3mm height) share identical 6×6mm pad pattern — one dual footprint covers both. Populate TH for prototyping; swap to SMD if height constrained at layout. SW1–SW3 nav buttons (Up/Down/Sel) are off-board panel buttons via J_SW1–J_SW3 2-pin connectors. STM32 internal pull-up — no external resistor on signal line. | DECIDED
51 | Display | J_DISP_I2C: B4B-XH-A 4-pin XH TH — I2C displays (SSD1306 etc). J_DISP_SPI: B8B-XH-A 8-pin XH TH — 8-pin SPI modules (MSP1901 ST7789). | J_DISP_I2C: GND/VCC/SCL(PB10)/SDA(PB11). I2C2 at 400kHz. J_DISP_SPI: GND/VCC/SCK(PB10)/MOSI(PB11)/RES(PB14)/DC(PB13)/CS(PB12)/BLK(PB15). PB10/PB11 dual-mapped I2C2/SPI2 — AF mux in firmware, one display at a time. Matches MSP1901 8-pin header directly. Both JST XH 2.5mm TH vertical. | DECIDED
52 | Display | Display bus is I2C2 — completely independent from I2C1 (INA226/PN532/sensors). | I2C1: sensor bus — INA226(0x40), PN532(0x24), spare. I2C2: display bus — SSD1306(0x3C) or any I2C display. Separate peripheral, DMA, interrupt. Bus speeds independently configurable. No address conflicts possible between buses. I2C3 also available on G0B1CC — spare for future expansion. | DECIDED
53 | Display | Backlight on PB15 — TIM1_CH3N capable. Supports PWM dimming, not just on/off. | Allows firmware to dim display during idle or save power. I2C OLEDs (SSD1306) are self-emitting — BL pin unused. SPI TFT displays typically have a BL LED driven by small transistor on module; BL pin controls that transistor. PWM frequency ~1kHz adequate for flicker-free dimming. DMA-capable timer output. | DECIDED
54 | Ordering | Packaging type not relevant (tube/cut tape/bulk). Priority: lowest per-unit at qty 1–10. | Manual assembly of small number of boards. DigiKey cut tape / AliExpress singles acceptable. | DECIDED
55 | Packages | Preferred: 0603 passives, TSSOP/VSSOP for ICs, LQFP48 for STM32. Not hard requirements. | 0603 comfortable for hand soldering. 0402 acceptable. TH acceptable for transistors and connectors during prototyping. Footprints on unselected GENERIC parts are indicative only — choose at layout time based on availability and board density. | DECIDED

Sheet: Legend
BOM Status Key & Column Guide
SELECTED | Part chosen — MPN confirmed, ready for ordering/schematic.
TBD | Category decided, specific part pending selection.
PENDING | Decision not yet made.
DUAL | Dual footprint — two compatible parts fit same pads. Populate one only.
REVIEW | Requires attention — obsolescence, lead time, or tariff issue flagged.
OBSOLETE | Part discontinued — do not order. See notes for alternative.
GENERIC | Generic commodity spec — family reference. Order from a specific selected option.
Column Guide
MFR Datasheet | Hyperlink to manufacturer's own PDF datasheet (primary source).
DK Datasheet | Hyperlink to DigiKey's copy of datasheet (fallback if MFR link fails).
Price 1x | Approximate per-unit price at qty 1. Verify live before ordering — tariffs change.
Price 10x | Approximate per-unit price at qty 10.
Stock | Stock status at time of BOM creation. Verify live before ordering.
Package/Ordering | Packaging guidance. Packaging type not constrained — cut tape, tube, bulk all acceptable. Priority: lowest per-unit cost at small quantity. Avoid full-reel minimums.
Tab structure | Bay PCB BOM = board components. Bay Module BOM = PCB + NFC + cable. Robot Cart BOM = N modules + Pi + chargers + cart hardware.
