tuffinmuffin/battery-cart/CAD/Fan/FanPedestal (Assembly) v1.step

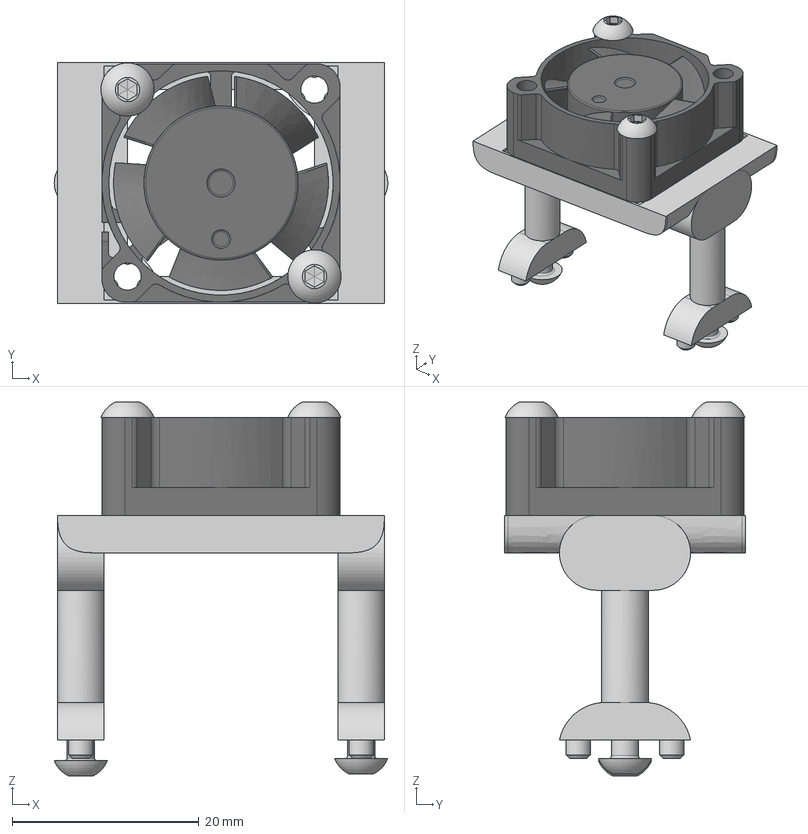
[picture p2: CAD file, 2026-05-02]
CAD/Fan/FanPedestal (Assembly) v1.step
35.7 x 25.8 x 40.0 mm
FanPedestal
Blades
ISO 7380-1 - M3 x 14 Steel 4.6 Plain x 2
ISO 7380-1 - M3 x 8 Steel 4.6 Plain x 2
