tuffinmuffin/battery-cart/CAD/Touch/TTP223Button.STEP

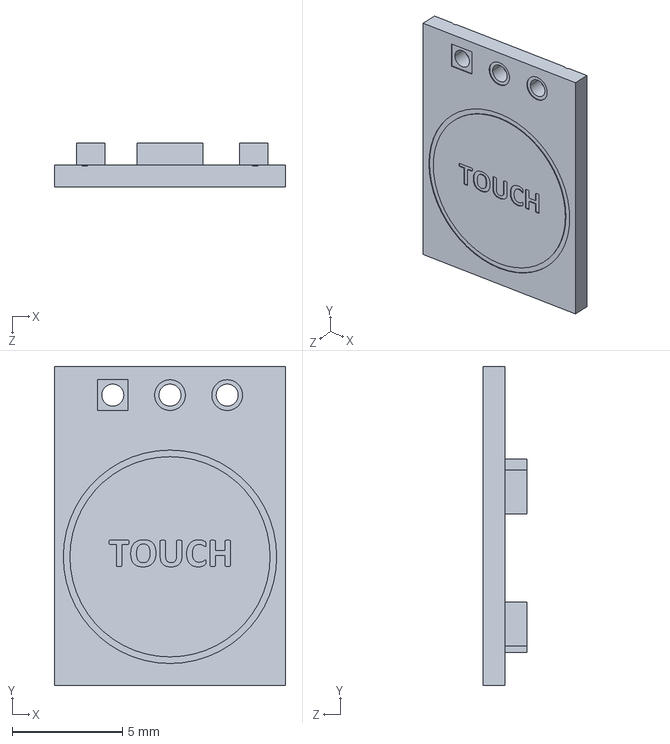
[picture p4: CAD file, 2026-05-02]
CAD/Touch/TTP223Button.STEP
10.5 x 14.5 x 2.00 mm
