tuffinmuffin/battery-cart/CAD/Touch/TTP223ButtonModel.step

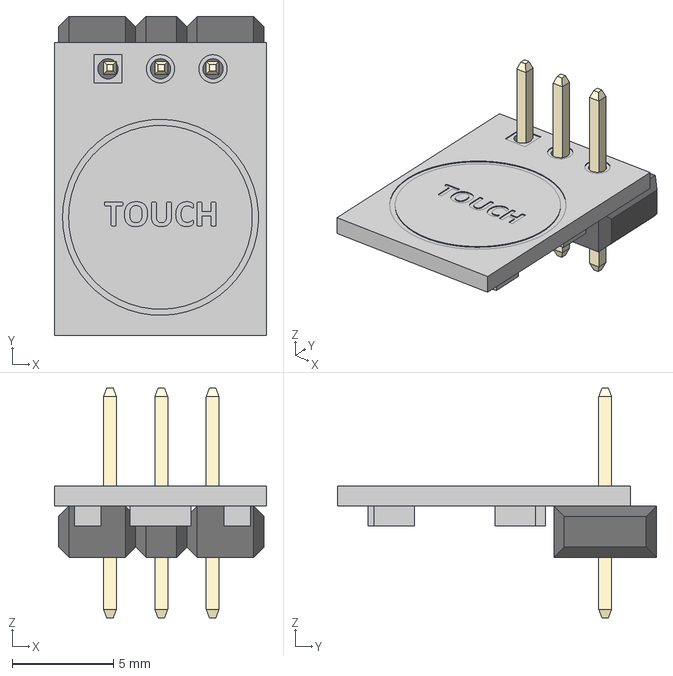
[picture p5: CAD file, 2026-05-02]
CAD/Touch/TTP223ButtonModel.step
10.5 x 15.8 x 11.4 mm
touch button TTP223
