tuffinmuffin/battery-cart/CAD/BatteryMonitorModule_V1/BatteryMonitorModule/BatteryMonitorModule.kicad_pcb

## KiCad design CAD/BatteryMonitorModule_V1/BatteryMonitorModule/BatteryMonitorModule.kicad_pcb (2026-05-16)

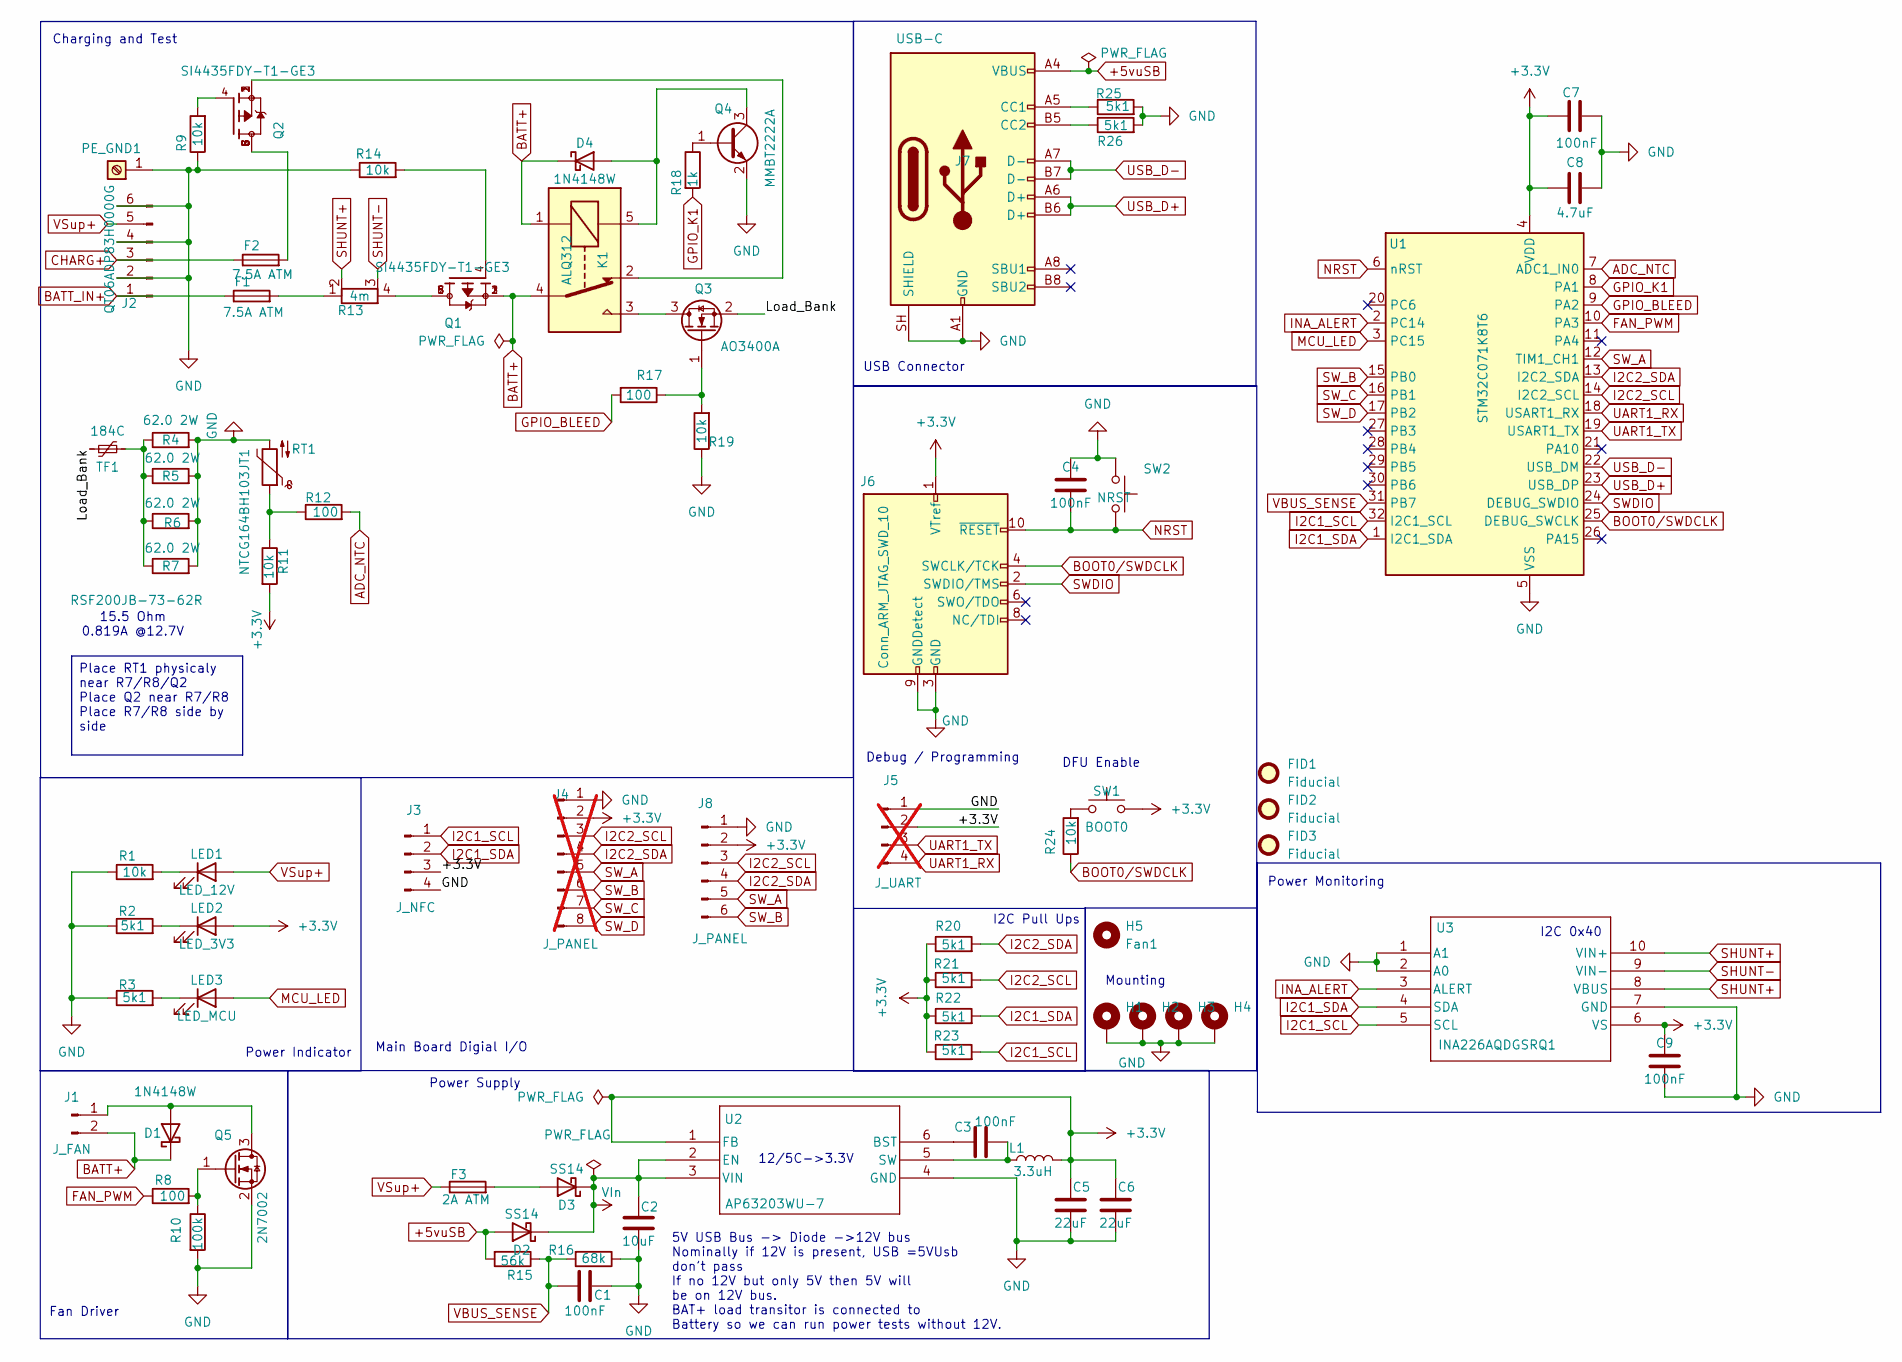
[picture p6: schematic BatteryMonitorModule.kicad_sch, Battery Monitor Module]

Parts:
C1, C3, C4, C7, C9: 100nF; C_0402_1005Metric; MPN CL05B104KO5NNNC; Digikey PN 1276-1001-6-ND
C2: 10uF; C_0805_2012Metric; MPN CL21A106KAYNNNG; Digikey PN 1276-6454-6-ND
C5, C6: 22uF; C_0805_2012Metric; MPN CL21A226MQQNNNE; Digikey PN 1276-1100-6-ND
C8: 4.7uF; C_0603_1608Metric; MPN CL10A475KP8NNNC; Digikey PN 1276-1044-6-ND
D1, D4: 1N4148W; D_SOD-123; MPN 1N4148W; Digikey PN 5399-1N4148WDKR-ND
D2, D3: SS14; D_SOD-123; MPN SS14; Digikey PN 5399-SS14DKR-ND
F1, F2: 7.5A ATM; FUSE_BK-6013; MPN BK-6013; Digikey PN BK-6013-ND
F3: 2A ATM; FUSE_BK-6013; MPN BK-6013; Digikey PN BK-6013-ND
FID1, FID2, FID3: Fiducial; Fiducial_0.5mm_Mask1.5mm
H1, H2, H3, H4: MountingHole_Pad; MountingHole_3.2mm_M3_DIN965_Pad
H5: Fan1; 2510FanOverhead
J1: J_FAN; PinHeader_1x02_P2.54mm_Vertical; MPN B2B-XH-A; Digikey PN 455-B2B-XH-A-ND
J2: QT06ADP83H0000G; MPN QT06ADP83H0000G; Digikey PN 1818-QT06ADP83H0000G-ND
J3: J_NFC; JST_XH_B4B-XH-A_1x04_P2.50mm_Vertical; MPN B4B-XH-A; Digikey PN 455-B4B-XH-A-ND
J4: J_PANEL; JST_XH_B8B-XH-AM_1x08_P2.50mm_Vertical; not fitted
J5: J_UART; PinHeader_1x04_P2.54mm_Vertical; not fitted
J6: Conn_ARM_JTAG_SWD_10; PinHeader_2x05_P1.27mm_Vertical; MPN Generic; Digikey PN N/A
J7: USB-C; SAMESKY_UJ20-C-H-G-SMT-1-P16-TR; PARTREV A4; Digikey PN 2223-UJ20-C-H-G-SMT-1-P16-TRDKR-ND
J8: J_PANEL; PinHeader_2x03_P2.54mm_Vertical
K1: ALQ312; Relay_SPDT_Omron-G5Q-1; MPN ALQ312
L1: 3.3uH; IND_BOURNS_SRR4028; MPN SRR4028-3R3Y; Digikey PN SRR4028-3R3YTR-ND
LED1: LED_12V; LED_0603_1608Metric; MPN LTST-C190KGKT; Digikey PN 160-1435-6-ND
LED2: LED_3V3; LED_0603_1608Metric; MPN LTST-C190KGKT; Digikey PN 160-1435-6-ND
LED3: LED_MCU; LED_0603_1608Metric; MPN LTST-C190KGKT; Digikey PN 160-1435-6-ND
PE_GND1: Keystone 4966; KEYSTONE_4966; MPN 4966; Digikey PN 36-4966-ND
Q1, Q2: SI4435FDY-T1-GE3; SOIC-8_3.9x4.9mm_P1.27mm; PARTREV I; Digikey PN SI4435FDY-T1-GE3DKR-ND
Q3: AO3400A; SOT-23; MPN AO3400A; Digikey PN 785-1000-2-ND
Q4: MMBT2222A; SOT-23; MPN MMBT2222A; Digikey PN 5399-MMBT2222ADKR-ND
Q5: 2N7002; SOT-23; MPN 2N7002; Digikey PN 5399-2N7002TR-ND
R1, R9, R11, R14, R19, R24: 10k; R_0402_1005Metric; MPN RMCF0402FT10K0; Digikey PN RMCF0402FT10K0DKR-ND
R2, R3, R20, R21, R22, R23, R25, R26: 5k1; R_0402_1005Metric; MPN RMCF0402FT5K10; Digikey PN RMCF0402FT5K10DKR-ND
R4, R5, R6, R7: 62.0 2W; R_Axial_DIN0516_L15.5mm_D5.0mm_P5.08mm_Vertical; MPN RR03J62RTB; Digikey PN A138481CT-ND
R8, R12, R17: 100; R_0402_1005Metric; MPN RC0402FR-07100RL; Digikey PN 311-100LRDKR-ND
R10: 100k; R_0402_1005Metric; MPN RC0402FR-07100KL; Digikey PN 311-100KLRDKR-ND
R13: 4m; R_Shunt_Vishay_WSK2512_6332Metric_T2.21mm; MPN PEWF2512F4L00Q9; Digikey PN 4506-PEWF2512F4L00Q9CT-ND
R15: 56k; R_0402_1005Metric; MPN RK73B1ETTP563J; Digikey PN 2019-RK73B1ETTP563JDKR-ND
R16: 68k; R_0402_1005Metric; MPN RMCF0402FT68K0; Digikey PN RMCF0402FT68K0DKR-ND
R18: 1k; R_0402_1005Metric; MPN RC0402FR-071KL; Digikey PN 311-1.00KLRDKR-ND
RT1: NTCG164BH103JT1; R_0603_1608Metric; MPN NTCG164BH103JT1; Digikey PN 445-174327-6-ND
SW1: BOOT0; SW_SPST_FSMSM; MPN FSMSM; Digikey PN 450-1140-ND
SW2: NRST; SW_SPST_FSMSM; MPN FSMSM; Digikey PN 450-1140-ND
TF1: 184C; R_Axial_DIN0516_L15.5mm_D5.0mm_P20.32mm_Horizontal; MPN RT184; Digikey PN 317-RT184-ND
U1: STM32C071K8T6; LQFP-32_7x7mm_P0.8mm; MPN STM32C071K8T6; Digikey PN 497-STM32C071K8T6-ND
U2: AP63203WU-7; SOT-23-6_Handsoldering; MPN AP63203WU-7; Digikey PN AP63203WU-7DIDKR-ND
U3: INA226AQDGSRQ1; MSOP-10_3x3mm_P0.5mm; MPN INA237AIDGSR; Digikey PN 296-INA237AIDGSRCT-ND

Connections:
+3.3V: C5.1, C6.1, C7.1, C8.1, C9.1, J3.3, J4.2, J5.2, J6.1 (VTref), J8.2, L1.2, LED2.2 (A), R11.2, R20.1, R21.1, R22.1, R23.1, SW1.2, U1.4 (VDD), U2.1 (FB), U3.6 (VS)
+5vuSB: D2.2 (A), J7.A4 (VBUS), J7.A9 (VBUS), J7.B4 (VBUS), J7.B9 (VBUS), R15.2
/Load_Bank: Q3.2 (S), TF1.1
ADC_NTC: R12.2, U1.7 (ADC1_IN0)
BATT+: D1.1 (K), D4.1 (K), J1.2, K1.1, K1.4, Q1.1, Q1.2, Q1.3
BATT_IN+: F1.1, J2.1
BOOT0/SWDCLK: J6.4 (SWCLK/TCK), R24.1, U1.25 (DEBUG_SWCLK)
CHARG+: F2.1, J2.3
FAN_PWM: R8.1, U1.10 (PA3)
GND: C1.2, C2.2, C4.1, C5.2, C6.2, C7.2, C8.2, C9.2, H1.1 (1_1), H2.1 (1_1), H3.1 (1_1), H4.1 (1_1), J2.2, J2.4, J2.6, J3.4, J4.1, J5.1, J6.3 (GND), J6.5 (GND), J6.9 (GNDDetect), J7.A1 (GND), J7.A12 (GND), J7.B1 (GND), J7.B12 (GND), J7.SH (SHIELD), J8.1, PE_GND1.1 (Pin_1_1), Q4.2 (E), Q5.2 (S), R1.1, R2.1, R3.1, R4.2, R5.2, R6.2, R7.2, R9.1, R10.2, R14.1, R16.1, R19.1, R25.2, R26.2, RT1.2, SW2.1, U1.5 (VSS), U2.4 (GND), U3.1 (A1), U3.2 (A0), U3.7 (GND)
GPIO_BLEED: R17.2, U1.9 (PA2)
GPIO_K1: R18.2, U1.8 (PA1)
I2C1_SCL: J3.1, R23.2, U1.32 (I2C1_SCL), U3.5 (SCL)
I2C1_SDA: J3.2, R22.2, U1.1 (I2C1_SDA), U3.4 (SDA)
I2C2_SCL: J4.3, J8.3, R21.2, U1.14 (I2C2_SCL)
I2C2_SDA: J4.4, J8.4, R20.2, U1.13 (I2C2_SDA)
INA_ALERT: U1.2 (PC14), U3.3 (ALERT)
MCU_LED: LED3.2 (A), U1.3 (PC15)
NRST: C4.2, J6.10 (~RESET), SW2.2, U1.6 (nRST)
unnamed: D1.2 (A), J1.1, Q5.3 (D)
unnamed: D3.2 (A), F3.2
unnamed: D4.2 (A), K1.5, Q4.3 (C)
unnamed: F1.2, R13.1
unnamed: F2.2, Q2.5, Q2.6, Q2.7, Q2.8
unnamed: J7.A5 (CC1), R25.1
unnamed: J7.B5 (CC2), R26.1
unnamed: K1.2, Q2.1, Q2.2, Q2.3
unnamed: LED1.1 (K), R1.2
unnamed: LED2.1 (K), R2.2
unnamed: LED3.1 (K), R3.2
unnamed: Q1.4, R14.2
unnamed: Q1.5, Q1.6, Q1.7, Q1.8, R13.4
unnamed: Q2.4, R9.2
unnamed: K1.3, Q3.3 (D)
unnamed: Q3.1 (G), R17.1, R19.2
unnamed: Q4.1 (B), R18.1
unnamed: Q5.1 (G), R8.2, R10.1
unnamed: R4.1, R5.1, R6.1, R7.1, TF1.2
unnamed: R11.1, R12.1, RT1.1
unnamed: R24.2, SW1.1
unnamed: C3.1, U2.6 (BST)
unnamed: C3.2, L1.1, U2.5 (SW)
SHUNT+: R13.2, U3.8 (VBUS), U3.10 (VIN+)
SHUNT-: R13.3, U3.9 (VIN-)
SWDIO: J6.2 (SWDIO/TMS), U1.24 (DEBUG_SWDIO)
SW_A: J4.5, J8.5, U1.12 (TIM1_CH1)
SW_B: J4.6, J8.6, U1.15 (PB0)
SW_C: J4.7, U1.16 (PB1)
SW_D: J4.8, U1.17 (PB2)
UART1_RX: J5.4, U1.18 (USART1_RX)
UART1_TX: J5.3, U1.19 (USART1_TX)
USB_D+: J7.A6 (D+), J7.B6 (D+), U1.23 (USB_DP)
USB_D-: J7.A7 (D-), J7.B7 (D-), U1.22 (USB_DM)
VBUS_SENSE: C1.1, R15.1, R16.2, U1.31 (PB7)
VIn: C2.1, D2.1 (K), D3.1 (K), U2.2 (EN), U2.3 (VIN)
VSup+: F3.1, J2.5, LED1.2 (A)

Notes on the sheet:
15.5 Ohm 0.819A @12.7V
Power Indicator
Power Monitoring
12/5C->3.3V
Power Supply
Charging and Test
USB Connector
I2C 0x40
Mounting
DFU Enable
Main Board Digial I/O
Fan Driver
5V USB Bus -> Diode ->12V bus Nominally if 12V is present, USB =5VUsb don't pass If no 12V but only 5V then 5V will be on 12V bus. BAT+ load transitor is connected to Battery so we can run power tests without 12V.
Debug / Programming
I2C Pull Ups
Place RT1 physicaly near R7/R8/Q2 Place Q2 near R7/R8 Place R7/R8 side by side

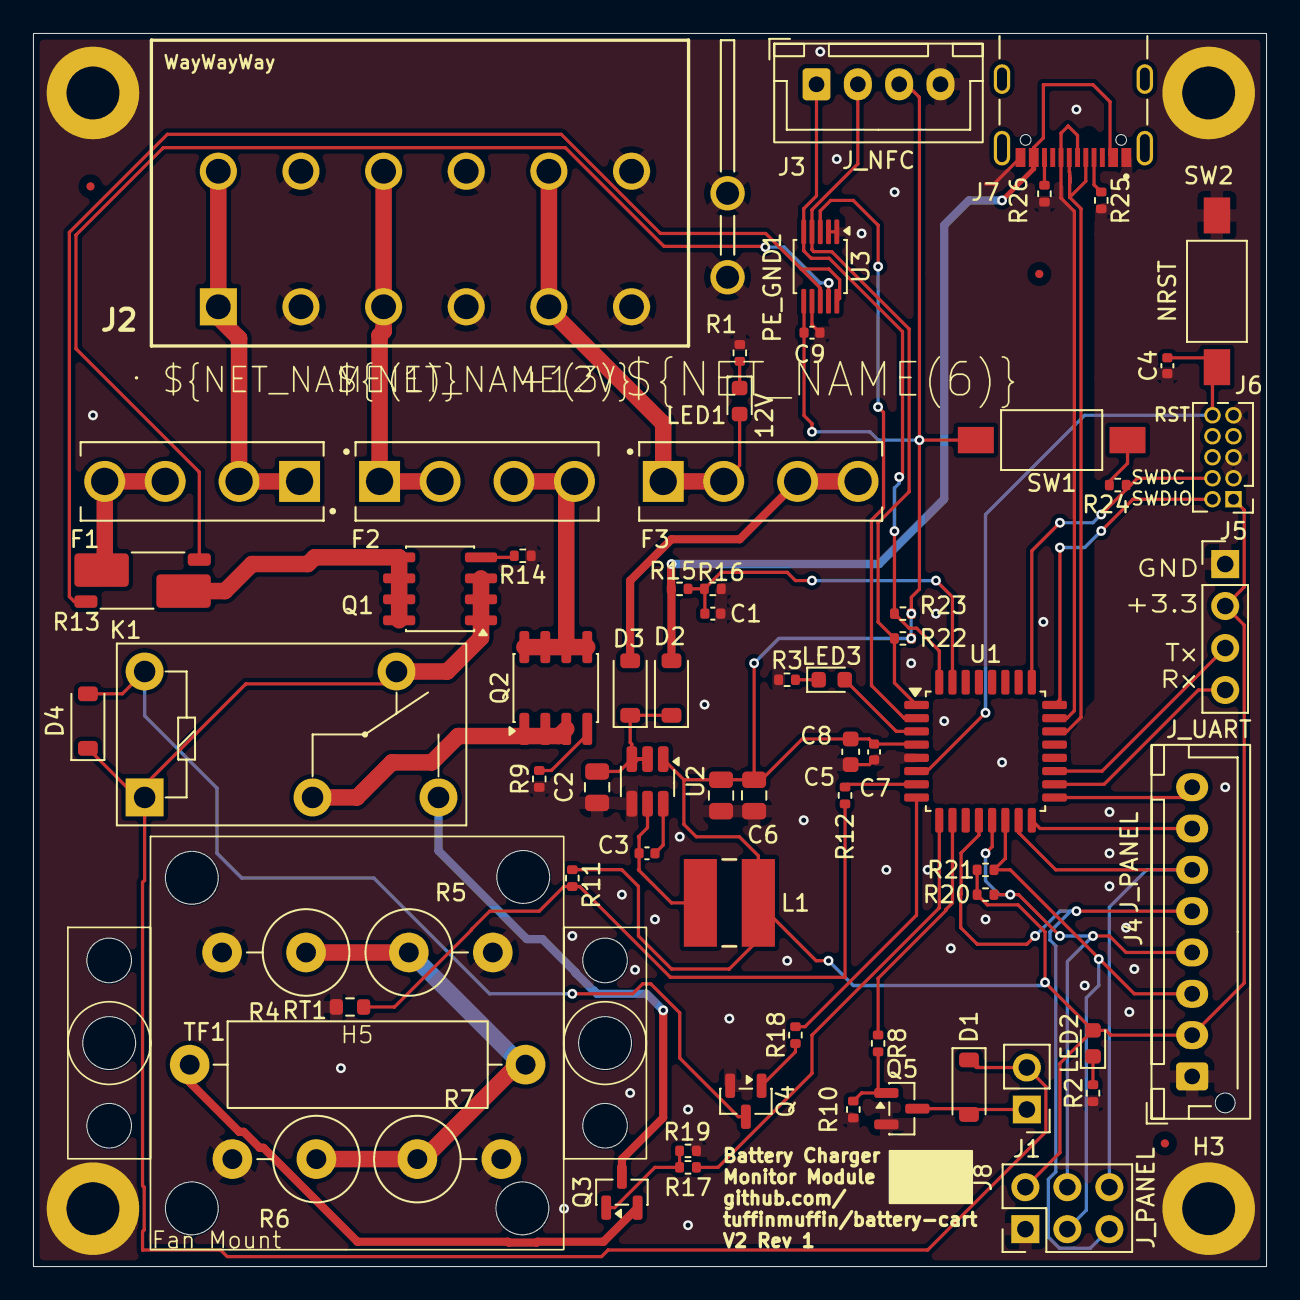
[picture p7: board BatteryMonitorModule.kicad_pcb from above]

Board: 2 copper layers, 74.6 x 74.6 mm, 76 parts (0 on the bottom side), 56 nets.
