tuffinmuffin/battery-cart/CAD/BatteryMonitorFrontPanel/BatteryMonitorFrontPanel/BatteryMonitorFrontPanel.kicad_pcb

## KiCad design CAD/BatteryMonitorFrontPanel/BatteryMonitorFrontPanel/BatteryMonitorFrontPanel.kicad_pcb (2026-05-02)

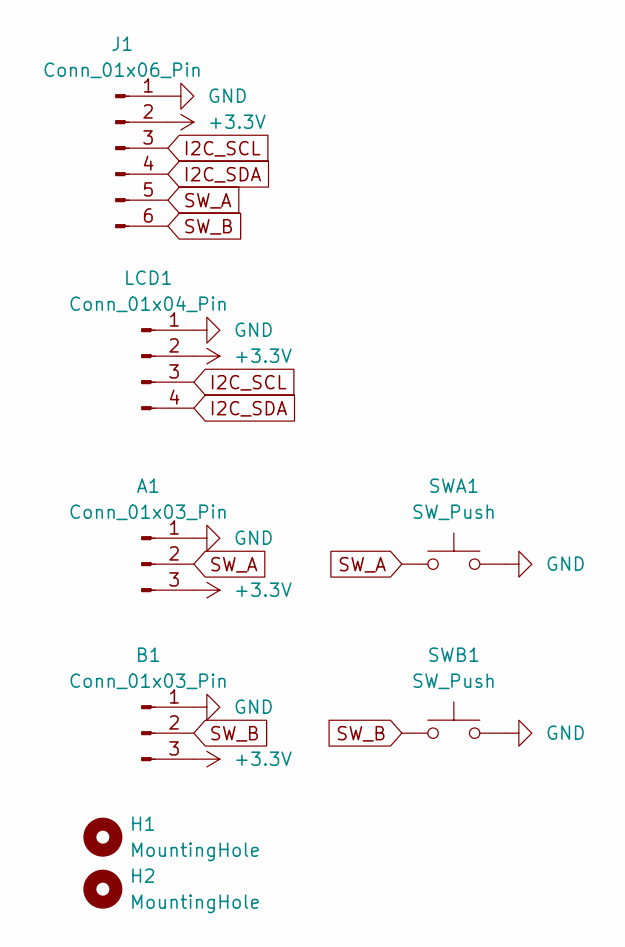
[picture p8: schematic BatteryMonitorFrontPanel.kicad_sch]

Parts:
A1: Conn_01x03_Pin; PinHeader_1x03_P2.00mm_Vertical
B1: Conn_01x03_Pin; PinHeader_1x03_P2.54mm_Vertical
H1, H2: MountingHole; MountingHole_3.2mm_M3
J1: Conn_01x06_Pin; PinHeader_2x03_P2.54mm_Horizontal
LCD1: Conn_01x04_Pin; PinHeader_1x04_P2.54mm_Vertical
SWA1: SW_Push; SW_PUSH_6mm_H5mm
SWB1: SW_Push; SW_PUSH_6mm_H5mm

Connections:
+3.3V: A1.3, B1.3, J1.2, LCD1.2
GND: A1.1, B1.1, J1.1, LCD1.1, SWA1.2, SWB1.2
I2C_SCL: J1.3, LCD1.3
I2C_SDA: J1.4, LCD1.4
SW_A: A1.2, J1.5, SWA1.1
SW_B: B1.2, J1.6, SWB1.1

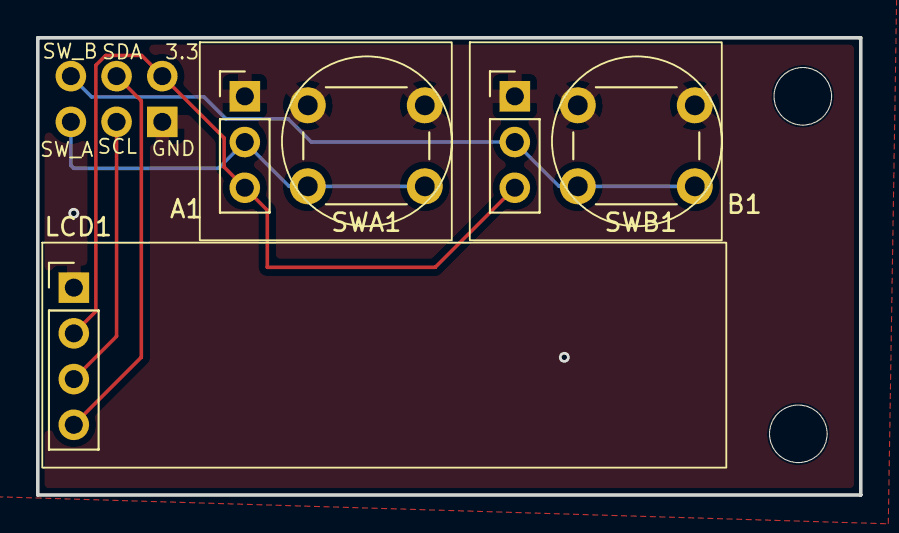
[picture p9: board BatteryMonitorFrontPanel.kicad_pcb from above]

Board: 2 copper layers, 45.7 x 25.4 mm, 8 parts (1 on the bottom side), 6 nets.
