tuffinmuffin/battery-cart/1-BatteryPowerPath.kicad_sch

## KiCad design 1-BatteryPowerPath.kicad_sch (2026-04-13)

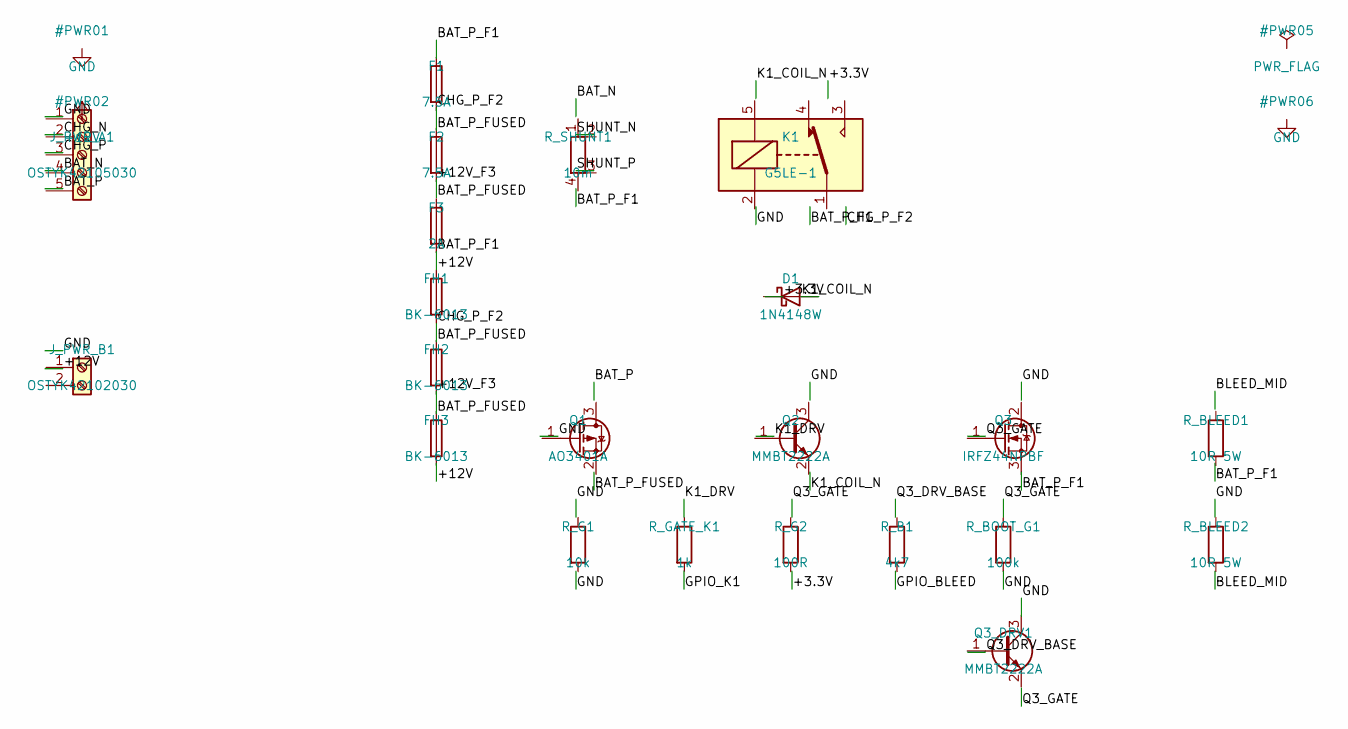
[picture p10: schematic 1-BatteryPowerPath.kicad_sch]

Parts:
D1: 1N4148W; D_SOD-123; MPN 1N4148W-7-F
F1, F2: 7.5A; Fuse_Blade_ATM_Mini; MPN ATM-7.5
F3: 2A; Fuse_Blade_ATM_Mini; MPN ATM-2
FH1, FH2, FH3: BK-6013; Fuse_Blade_ATM_Mini; MPN BK-6013
J_PWR_A1: OSTYK42105030; TerminalBlock_OnShore_OSTTE050161_1x05_P5.08mm_Horizontal; MPN OSTYK42105030
J_PWR_B1: OSTYK42102030; TerminalBlock_OnShore_OSTTE020161_1x02_P5.08mm_Horizontal; MPN OSTYK42102030
K1: G5LE-1; Relay_SPDT_Omron-G5LE-1; MPN G5LE-14-DC3
Q1: AO3401A; SOT-23; MPN AO3401A
Q2, Q3_DRV1: MMBT2222A; SOT-23; MPN MMBT2222ALT1G
Q3: IRFZ44NPBF; TO-220-3_Vertical; MPN IRFZ44NPBF
R_B1: 4k7; R_0603_1608Metric; MPN RC0603FR-074K7L
R_BLEED1, R_BLEED2: 10R 5W; R_Axial_DIN0516_L15.5mm_D5.3mm_P22.86mm_Horizontal; MPN SQP500JB-10R
R_BOOT_G1: 100k; R_0603_1608Metric; MPN RC0603FR-07100KL
R_G1: 10k; R_0603_1608Metric; MPN RC0603FR-0710KL
R_G2: 100R; R_0603_1608Metric; MPN RC0603FR-07100RL
R_GATE_K1: 1k; R_0603_1608Metric; MPN RC0603FR-071KL
R_SHUNT1: 10m; R_2512_6332Metric; MPN WSL2512R0100FEK18
