tuffinmuffin/battery-cart/Software/STMCubeV2/BatteryMonitorV2/BatteryMonitorV2.ioc

Mcu.UserName=STM32C071K8Tx
PA0.GPIO_Label=ADC_NTC
PA0.Signal=ADC1_IN0
PA1.GPIO_Label=GPIO_K1
PA1.Signal=GPIO_Output
PA13.Signal=DEBUG_SWDIO
PA14-BOOT0.Signal=DEBUG_SWCLK
PA2.GPIO_Label=GPIO_BLEED
PA2.Signal=GPIO_Output
PA3.GPIO_Label=FAN_PWM
PA3.Signal=S_TIM1_CH4
PA5.GPIO_Label=SW_A
PA5.Signal=GPIO_Input
PA6.Signal=I2C2_SDA
PA7.Signal=I2C2_SCL
PA8.Signal=USART1_RX
PA9.Signal=USART1_TX
PB0.GPIO_Label=SW_B
PB0.Signal=GPIO_Input
PB1.GPIO_Label=SW_C
PB1.Signal=GPIO_Input
PB2.GPIO_Label=SW_D
PB2.Signal=GPIO_Input
PB7.GPIO_Label=VSense_EXTI7
PB7.Signal=GPXTI7
PB8.Signal=I2C1_SCL
PB9.Signal=I2C1_SDA
PC14-OSCX_IN(PC14).GPIO_Label=INA_ALERT_EXTI14
PC14-OSCX_IN(PC14).Signal=GPXTI14
PC15-OSCX_OUT(PC15).GPIO_Label=MCU_LED
PC15-OSCX_OUT(PC15).Signal=GPIO_Output
