tuffinmuffin/battery-cart/Software/STMCubeV2/BatteryMonitorV2/Core/Inc/main.h

#define INA_ALERT_EXTI14_Pin GPIO_PIN_14
#define INA_ALERT_EXTI14_GPIO_Port GPIOC
#define INA_ALERT_EXTI14_EXTI_IRQn EXTI4_15_IRQn
#define MCU_LED_Pin GPIO_PIN_15
#define MCU_LED_GPIO_Port GPIOC
#define ADC_NTC_Pin GPIO_PIN_0
#define ADC_NTC_GPIO_Port GPIOA
#define GPIO_K1_Pin GPIO_PIN_1
#define GPIO_K1_GPIO_Port GPIOA
#define GPIO_BLEED_Pin GPIO_PIN_2
#define GPIO_BLEED_GPIO_Port GPIOA
#define FAN_PWM_Pin GPIO_PIN_3
#define FAN_PWM_GPIO_Port GPIOA
#define SW_A_Pin GPIO_PIN_5
#define SW_A_GPIO_Port GPIOA
#define SW_B_Pin GPIO_PIN_0
#define SW_B_GPIO_Port GPIOB
#define SW_C_Pin GPIO_PIN_1
#define SW_C_GPIO_Port GPIOB
#define SW_D_Pin GPIO_PIN_2
#define SW_D_GPIO_Port GPIOB
#define VSense_EXTI7_Pin GPIO_PIN_7
#define VSense_EXTI7_GPIO_Port GPIOB
#define VSense_EXTI7_EXTI_IRQn EXTI4_15_IRQn
