tuffinmuffin/battery-cart/(commit log)

2026-04-13 Initial commit: BatteryMonitorModule V9 KiCad project
    Add project schematic, PCB layout, sub-schematics, and .gitignore
    configured for KiCad (ignoring backups, autosaves, lock files, and
    user-specific local settings).
    [1-BatteryPowerPath.kicad_sch, 2-PowerSupply.kicad_sch, 3-MCU.kicad_sch, 4-IO.kicad_sch, BatteryMonitorModule.kicad_pcb, BatteryMonitorModule.kicad_sch]
2026-04-13 assigned mfg part numbers
    [BatteryMonitorModule.kicad_sch]
2026-04-13 Revert "assigned mfg part numbers"
    This reverts commit d05d25c7e7cb63e1a29fd6f965ec26ad4da439bc.
    [BatteryMonitorModule.kicad_sch]
2026-04-13 schematic wiring done
    [BatteryMonitorModule.kicad_sch, DGS0010A.stp]
2026-04-13 fixed instance reference designators
    [1-BatteryPowerPath.kicad_sch, BatteryMonitorModule.kicad_sch]
2026-04-14 restructured project into BatteryMonitorModule/ directory with renamed sub-schematics
    [01-PowerPath.kicad_sch, 02-PowerSupply.kicad_sch, 03-MCU.kicad_sch, 04-IO.kicad_sch, 2-PowerSupply.kicad_sch, 3-MCU.kicad_sch, 4-IO.kicad_sch, BatteryMonitorModule.kicad_pcb]
2026-04-14 schematic annotation and component placement for power supply, MCU, and power path sheets
    Added symbol libraries (AP63203, AP63205, MIC5219, TC2117), annotated
    ref designators, and placed components via MCP server. Includes
    fix_sheet_instances.py utility for restoring sheet_instances blocks.
    [01-PowerPath.kicad_sch, 02-PowerSupply.kicad_sch, 03-MCU.kicad_sch]
2026-04-15 updated MCU schematic — additional component placement and wiring
    [03-MCU.kicad_sch]
2026-04-15 updated power supply schematic — additional component placement and wiring
    [02-PowerSupply.kicad_sch]
2026-04-15 updated schematics — MCU and IO wiring updates, sheet instance fixes
    [01-PowerPath.kicad_sch, 02-PowerSupply.kicad_sch, 03-MCU.kicad_sch, 04-IO.kicad_sch]
2026-04-16 updated all schematics — IO sheet wiring, MCU connections, power supply refinements, custom footprints
    [01-PowerPath.kicad_sch, 02-PowerSupply.kicad_sch, 03-MCU.kicad_sch, 04-IO.kicad_sch, BatteryMonitorModule.kicad_sch]
2026-04-16 added connector footprints and power path updates
    New custom footprints: OSTYK screw terminals, KF8500 connectors, USB4085-GF-A.
    Power path schematic updates and project library references.
    [01-PowerPath.kicad_sch, 02-PowerSupply.kicad_sch, 03-MCU.kicad_sch]
2026-04-17 added 3D models, updated footprints, and schematic/PCB updates
    New 3D STEP models: AP63205, BK-6013 fuse holder, FSMSM switch,
    SRR4028 inductor, OSTYK screw terminals, USB4085, WSK2512 shunt,
    SQP500 resistor. Updated custom footprints with 3D model references.
    New BK-6013 fuse holder footprint.
    [01-PowerPath.kicad_sch, 02-PowerSupply.kicad_sch, 03-MCU.kicad_sch, 04-IO.kicad_sch, BatteryMonitorModule.kicad_pcb]
2026-04-17 design done commit
    [03-MCU.kicad_sch, 04-IO.kicad_sch, BatteryMonitorModule.kicad_pcb]
2026-04-17 V0 design updates — PCB layout refinements and power supply schematic fixes
    [02-PowerSupply.kicad_sch, BatteryMonitorModule.kicad_pcb]
2026-04-17 restructure repo — move git root to project level
    Move V0 design files under CAD/BatteryMonitorModule_V0/, add top-level
    Datasheet/, Design/, and Docs/ directories for project organization.
    Remove embedded .history submodule from tracking.
    [01-PowerPath.kicad_sch, 02-PowerSupply.kicad_sch, 03-MCU.kicad_sch, 04-IO.kicad_sch, BatteryMonitorModule.kicad_pcb, BatteryMonitorModule.kicad_sch, frc_bom_v19.xlsx]
2026-04-17 duplicate V0 design to V1 for rework
    Copy BatteryMonitorModule_V0 to BatteryMonitorModule_V1 as the starting
    point for the next design revision.
    [01-PowerPath.kicad_sch, 02-PowerSupply.kicad_sch, 03-MCU.kicad_sch, 04-IO.kicad_sch, BatteryMonitorModule.kicad_pcb, BatteryMonitorModule.kicad_sch]
2026-04-18 V1 schematic rework — PowerPath, PowerSupply, IO updates and custom library additions
    Add custom symbols/footprints for Keystone 4966 and AO4407A, and SOIC127P600X175-8N
    footprint. Update sym-lib-table to reference new custom library.
    [01-PowerPath.kicad_sch, 02-PowerSupply.kicad_sch, 04-IO.kicad_sch]
2026-04-19 add QT06ADP83H0000G and UJ20-C USB-C connector symbols/footprints/3D models
    Update V1 schematics (PowerPath, MCU, IO, top-level) to incorporate new parts.
    [01-PowerPath.kicad_sch, 03-MCU.kicad_sch, 04-IO.kicad_sch, BatteryMonitorModule.kicad_sch]
2026-04-20 add BatteryMonitorV2 STM32CubeMX project and V1 MCU schematic updates
    Initial STM32CubeMX .ioc for BatteryMonitorV2. Update MCU schematic and
    AP63205WU-7/INA226 custom symbols.
    [03-MCU.kicad_sch, BatteryMonitorModule.kicad_sch]
2026-04-20 assign M3 mounting hole footprints and rename F1 to TF1
    [BatteryMonitorModule.kicad_sch]
2026-04-20 V1 PCB layout updates and QT06ADP83H0000G footprint refinement
    [BatteryMonitorModule.kicad_pcb, BatteryMonitorModule.kicad_sch]
2026-04-20 add datasheets and G5Q-14 symbol, remove V1 sub-schematics
    Add Omron G5Q-14 relay and STM32C0 datasheets, plus fixed G5Q-14 custom symbol.
    Remove V1 sub-schematic files (PowerPath, PowerSupply, MCU, IO).
    [01-PowerPath.kicad_sch, 02-PowerSupply.kicad_sch, 03-MCU.kicad_sch, 04-IO.kicad_sch]
2026-04-29 PCB update
    [BatteryMonitorModule.kicad_pcb]
2026-04-30 V1 PCB and schematic updates
    [BatteryMonitorModule.kicad_pcb, BatteryMonitorModule.kicad_sch]
2026-04-30 add 2510 fan overhead footprint and reference image, footprint refinements, BatteryMonitorV2 .ioc updates
2026-04-30 add .gitattributes and renormalize line endings
    Declare KiCad text files as text eol=lf (clean cross-platform diffs) and
    STEP/PDF/PNG as binary. Stops autocrlf from generating spurious modifications
    on every working-tree touch. STEP files re-stored byte-for-byte (small size
    increase reflects baked-in CRLF — semantically identical to CAD readers).
2026-05-02 finalize BatteryMonitorModule V1: pcb/sch updates, JST XH 8-pin footprint, gerber export
    [BatteryMonitorModule.kicad_pcb, BatteryMonitorModule.kicad_sch]
2026-05-02 add BatteryMonitorFrontPanel project with gerber export
    [BatteryMonitorFrontPanel.kicad_pcb, BatteryMonitorFrontPanel.kicad_sch]
2026-05-02 add LCD, Touch, and FanPedestal assembly CAD models
    [FanPedestal (Assembly) v1.step, OLED_0.91_128x32.stp, TTP223Button.STEP, TTP223ButtonModel.step]
2026-05-16 found wiring error and fixed. Reved board from - to 1
    [BatteryMonitorModule.csv, BatteryMonitorModule.kicad_pcb, BatteryMonitorModule.kicad_sch]
2026-05-18 add STM32CubeMX starter code for BatteryMonitorV2
    Generated STM32C071K8T6 project with CMake/Starm-Clang toolchain.
    Includes HAL drivers, FreeRTOS (CMSIS-RTOS2), and peripheral init
    for ADC1, I2C1/I2C2, USART1, USB, TIM1, CRC, and DMAMUX.
2026-05-18 vendor TinyUSB 0.20.0 (CDC device, STM32C0 fsdev driver)
    ST does not ship STM32_USB_Device_Library for STM32C0 (only Azure USBX
    via X-CUBE-AZRTOS). We use TinyUSB instead for CDC ACM support.
    Trimmed from the upstream release tarball to just the subset we need:
    src/{tusb.c,tusb.h,tusb_option.h} + common/ + device/ + osal/ +
    class/cdc/ + portable/st/stm32_fsdev/. ~760 KB total. License: MIT.
    Source: github.com/hathach/tinyusb/releases/tag/0.20.0
    Version pin recorded in Middlewares/tinyusb/VERSION.txt.
2026-05-18 ioc: re-enable USB Device_Only, drop FreeRTOS heap to 8K
    Re-enable the USB peripheral (Device_Only, no middleware) so CubeMX
    continues to manage clock setup: HAL_PCD_MspInit configures HSI48, the
    USB clock mux, peripheral clock, and NVIC for us. HAL_PCD_Init runs at
    boot but is harmless — TinyUSB reprograms USB registers when tud_init()
    runs (IRQ is hijacked via USER CODE block in stm32c0xx_it.c, see next
    commit).
    Heap: configTOTAL_HEAP_SIZE 16384 -> 8192. We only run a handful of
    tasks (~1 KB stack each) plus the TinyUSB FreeRTOS queue; 8 KB is
    plenty and frees 8 KB of the 24 KB SRAM for .data/.bss/USB statics.
    Remove unused heap_1.c (we use heap_4).
    Also includes:
    - main.c init orde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
2026-05-18 wire TinyUSB CDC telemetry: 1 Hz ASCII counter over USB-FS
    Application-side integration that turns the new TinyUSB tree into a
    running CDC virtual COM port emitting `tick N\r\n` once per second.
    - CMakeLists.txt: pull in TinyUSB sources (tusb.c, tusb_fifo.c,
    usbd.c, usbd_control.c, cdc_device.c, dcd_stm32_fsdev.c) and
    usb_descriptors.c. Post-build objcopy to emit .bin alongside .elf.
    New `flash` custom target — depends on the main exe so
    `cmake --build <dir> --target flash` rebuilds + DFU-flashes in
    one go. Also visible in the CMake Tools target dropdown.
    - tusb_config.h: CFG_TUSB_MCU=OPT_MCU_STM32C0, OPT_OS_FREERTOS,
    CDC enabled with 64-byte buffers.
    - usb_d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
2026-05-18 ci: build firmware on GH Actions with ARM LLVM + memory budget check
    Adds a GitHub Actions workflow that builds the BatteryMonitorV2
    firmware on every push to main and every PR. Same compiler family as
    the local Windows build (LLVM Clang + picolibc) for cleaner parity
    than a generic GCC-based CI would give.
    - .github/workflows/firmware-build.yml: matrix build of ci-Debug
    and ci-Release. Downloads ARM's official LLVM Embedded Toolchain
    19.1.5 (Apache-2.0, github.com/ARM-software/LLVM-embedded-
    toolchain-for-Arm) directly — no third-party Actions. Cached
    across runs. Uploads .elf/.bin/.map as 30-day PR artifacts.
    - Software/STMCubeV2/BatteryMonitorV2/cmake/arm-clang.cma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
2026-05-18 ci: strip (READONLY) from linker script for ld.lld compatibility
    ARM LLVM Embedded Toolchain 19.1.5's ld.lld rejects the GNU ld
    `.section (READONLY) :` attribute that CubeMX-generated linker scripts
    use for .ARM.extab/.ARM.exidx/.preinit_array/.init_array/.fini_array.
    The attribute is purely a hint to the linker — sections still land in
    FLASH via the explicit `>FLASH` placement. Strip it in the CI working
    tree only. Local Windows builds (starm-clang + bundled GNU ld) still
    honor the attribute.
    Workaround scope: every CI run patches its own clone; the committed
    linker script keeps the CubeMX-generated form so regens don't drift.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
2026-05-18 ci: add clang-tidy static analysis (CI + local + VS Code)
    Adds a lint job to firmware-build.yml that runs clang-tidy on hand-
    written embedded C, plus a portable script and VS Code tasks for the
    same workflow locally.
    - Software/STMCubeV2/BatteryMonitorV2/.clang-tidy: embedded-friendly
    check set (bugprone, cert, clang-analyzer, misc, performance) with
    specific exclusions for noisy/inapplicable rules (parameter
    swappability, reserved identifiers used by HAL, include cleaner,
    no-recursion in callbacks, unused-parameters for the (void)arg
    idiom).
    - Software/STMCubeV2/BatteryMonitorV2/scripts/lint.py: wraps
    clang-tidy. Auto-detects compile_commands.json in build/Debu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
    [lint.py]
2026-05-18 clang-tidy: silence noise, fix _desc_str rename + signed-char cast
    Triaged the 14 warnings from the first lint run:
    - Disabled `misc-use-internal-linkage` globally. The check is correct
    in principle but flags CubeMX-managed `defaultTaskHandle` etc. that
    live outside USER CODE blocks and can't be marked static without
    being lost on the next regen. Apply `static` manually to our own
    additions instead (done for the descriptor arrays below).
    - Disabled `performance-no-int-to-ptr`. STM32 HAL register macros
    (GPIOA, USB_DRD_FS, etc.) all expand to int→ptr casts; that's the
    MMIO design, not a smell.
    - usb_descriptors.c: renamed `_desc_str` to `desc_str` to satisfy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
2026-05-18 ci: wire system clang-tidy to ARM cross-toolchain headers
    ARM LLVM Embedded Toolchain doesn't ship clang-tidy — it's a build-only
    distro (clang, clang++, lld, llvm-* only). To run clang-tidy against
    arm-none-eabi sources in CI we combine two pieces:
    1. apt-install system clang-tidy (Ubuntu LLVM 18) as the analyzer
    2. Query /opt/llvm-arm/bin/clang for its full implicit include
    search path at the cortex-m0plus target (`-v -E` output, parsing
    between "#include <...> search starts here" and "End of search
    list"). Pass each as `--extra-arg=-isystem<dir>` so clang-tidy
    sees the same picolibc headers (inttypes.h, etc.) the real ARM
    compiler does.
    Also added `--extra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
    [lint.py]
2026-05-18 chore: extend .gitattributes for source, .gitignore for CubeMX backups (#2)
    Working copy was perpetually showing 100+ files as "modified" because
    git's autocrlf on Windows kept oscillating CRLF<->LF without explicit
    rules for C/CMake/etc. Extended .gitattributes:
    - *.c, *.h, *.cpp, *.hpp, *.s, *.S, *.ld, *.cmake, CMakeLists.txt,
    CMakePresets.json, .clang-tidy, .clangd: text eol=lf
    - *.json, *.yml/.yaml, *.toml, *.md, *.txt, *.cfg: text eol=lf
    - *.py, *.sh: text eol=lf
    - *.ps1, *.bat, *.cmd: text eol=crlf (Windows shells prefer it)
    git add --renormalize . then unified the working tree. Only one file
    (cmake/stm32cubemx/CMakeLists.txt) had real CRLF in index that needed
    flipping t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
2026-05-19 ci: local clang-tidy via WSL Ubuntu (mirrors CI exactly) (#3)
    Adds a WSL-backed local lint workflow so static analysis runs the same
    way locally and in CI: apt-installed clang-tidy as the analyzer + ARM
    LLVM Embedded Toolchain at /opt/llvm-arm for the cross-compile headers.
    Native Windows clang-tidy can't do this — it lacks arm-none-eabi
    picolibc headers — and ST's starm-clang bundle doesn't ship clang-tidy.
    - scripts/setup-wsl.sh: one-time WSL Ubuntu setup. apt installs
    clang-tidy / cmake / ninja / python3 / curl, then downloads ARM
    LLVM 19.1.5 to /opt/llvm-arm (matches CI). Re-runnable, idempotent.
    - scripts/run-lint.sh: day-to-day driver. Configures the ci-Debug
    prese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
    [lint.py]
2026-05-19 feat(io): add UT and basic direct_io module — LED/relay/bleed/fan helpers (#4)
    * feat(io): add direct_io module — LED/relay/bleed/fan helpers
    Thin, testable wrappers over the board's GPIO outputs and fan PWM.
    This gives application code a vocabulary (`led_toggle`, `relay_enable`,
    `fan_set_duty`) instead of scattering raw HAL_GPIO_*/__HAL_TIM_*
    calls everywhere, and it's the first piece of business logic worth
    unit testing with mocks (next PR).
    - Core/Inc/direct_io.h + Core/Src/direct_io.c: led_toggle/enable/
    disable, relay_enable/disable, bleed_enable/disable, fan_init,
    fan_set_duty (0..100% clamped). Active-high convention.
    - Core/Src/app_freertos.c: StartDefaultTask now c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
2026-05-20 INA238 driver + cdc_print + FLASH size reduction+ linker rename (#5)
    * feat(ina238): driver + i2c_bus mutex/DMA + smoke task
    - Driver: INA238 with INA237 compat (identical register map + scaling).
    ina238_probe() accepts either device ID and records the variant in
    dev->detected_device_id.
    - Bus wrapper (Core/Src/i2c_bus.c): mutex for I2C1 sharing (INA238 +
    future PN532), DMA-completion semaphore, HAL callback overrides.
    - CubeMX regen: I2C1 SMBus-slave -> I2C master, NoStretch=Disable
    (PN532-friendly), DMA1 ch1/ch2 TX/RX, ~338 kHz on PCLK1=48 MHz.
    SMBus HAL files dropped.
    - Smoke task: bus scan, raw MFG/DEV ID dump, register-state dump after
    configure, 1 Hz sample loop with K1 re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
    [BatteryMonitorModule.kicad_sch]
2026-05-20 OLED display: u8g2 + SSD1306 driver + main stats layout v1 (#6)
    * chore(u8g2): vendor 2.36.19 (engine + SDL backend, no stock fonts)
    Vendored from https://github.com/olikraus/u8g2/releases/tag/2.36.19
    under Middlewares/u8g2/ for the upcoming SSD1116/SSD1306 128x32
    display driver.
    What's included:
    - csrc/ u8g2 engine + every display driver (--gc-sections
    drops the unused dispatchers at link time;
    source size is small enough)
    - sys/sdl/common/ u8g2's SDL2 backend for the desktop layout sim
    (will be wired up via tools/sim/ in a later commit)
    - LICENSE, ChangeLog, README.md, VERSION.txt
    Wha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
2026-05-21 Display architecture v1: render dispatch + controller + 2-button input + state map (#7)
    * feat(display_state): state→label map (decouples internal vs user-visible)
    Step 1 of the display architecture build-out (see plan). Tiny
    indexed lookup so the controller / render layer can render a
    state's user-visible string without baking it into either.
    The intentional rename is the point: internal TRICKLE state shows
    on screen as "Charged" — that's what the user wants to see when
    their battery is full and we're holding it on the float charge.
    The map keeps the internal vocabulary precise.
    Out-of-range states return "?" so a future enum extension the
    producer hasn't told the renderer about rend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
2026-05-28 Charge state machine v1: 9-state FSM skeleton + event queue + safety entry (#8)
    Lands the framework for the battery-charge controller: lifecycle
    (init/task_start), snapshot publish under a mutex (mirrors
    monitor_state pattern), single osMessageQueue for command + safety
    events, apply_outputs() enforcing the SPDT bleed-off-before-K1
    sequencing invariant, and the charge_state_tick() seam exposed for
    host tests.
    Wired transitions:
    - INIT -> IDLE on the first tick after boot
    - IDLE <-> MONITOR via cmd_enter / cmd_exit
    - IDLE -> CHARGE_PREPARE when Vbus crosses V_PRESENT for
    T_PRESENT_SAMPLES consecutive ticks (V0 captured at the moment
    of decision; pretest pulse lands in a follow-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
