tuffinmuffin/battery-cart/(notices)

Notices in the files:
Software/STMCubeV2/BatteryMonitorV2/Core/Src/app_freertos.c:
Copyright (c) 2026 STMicroelectronics.
All rights reserved.
This software is licensed under terms that can be found in the LICENSE file
